Ganghyeok/EEG-Measurement_Brain-Stimulation_System/README.md

# EEG-Measurement_Brain-Stimulation_System
