Ganghyeok/EEG-Measurement_Brain-Stimulation_System/Hardware/EEG_Ver1.0A/PDF/2_EEG_Ver1.0A(회로도 1차 검토 완료본).pdf

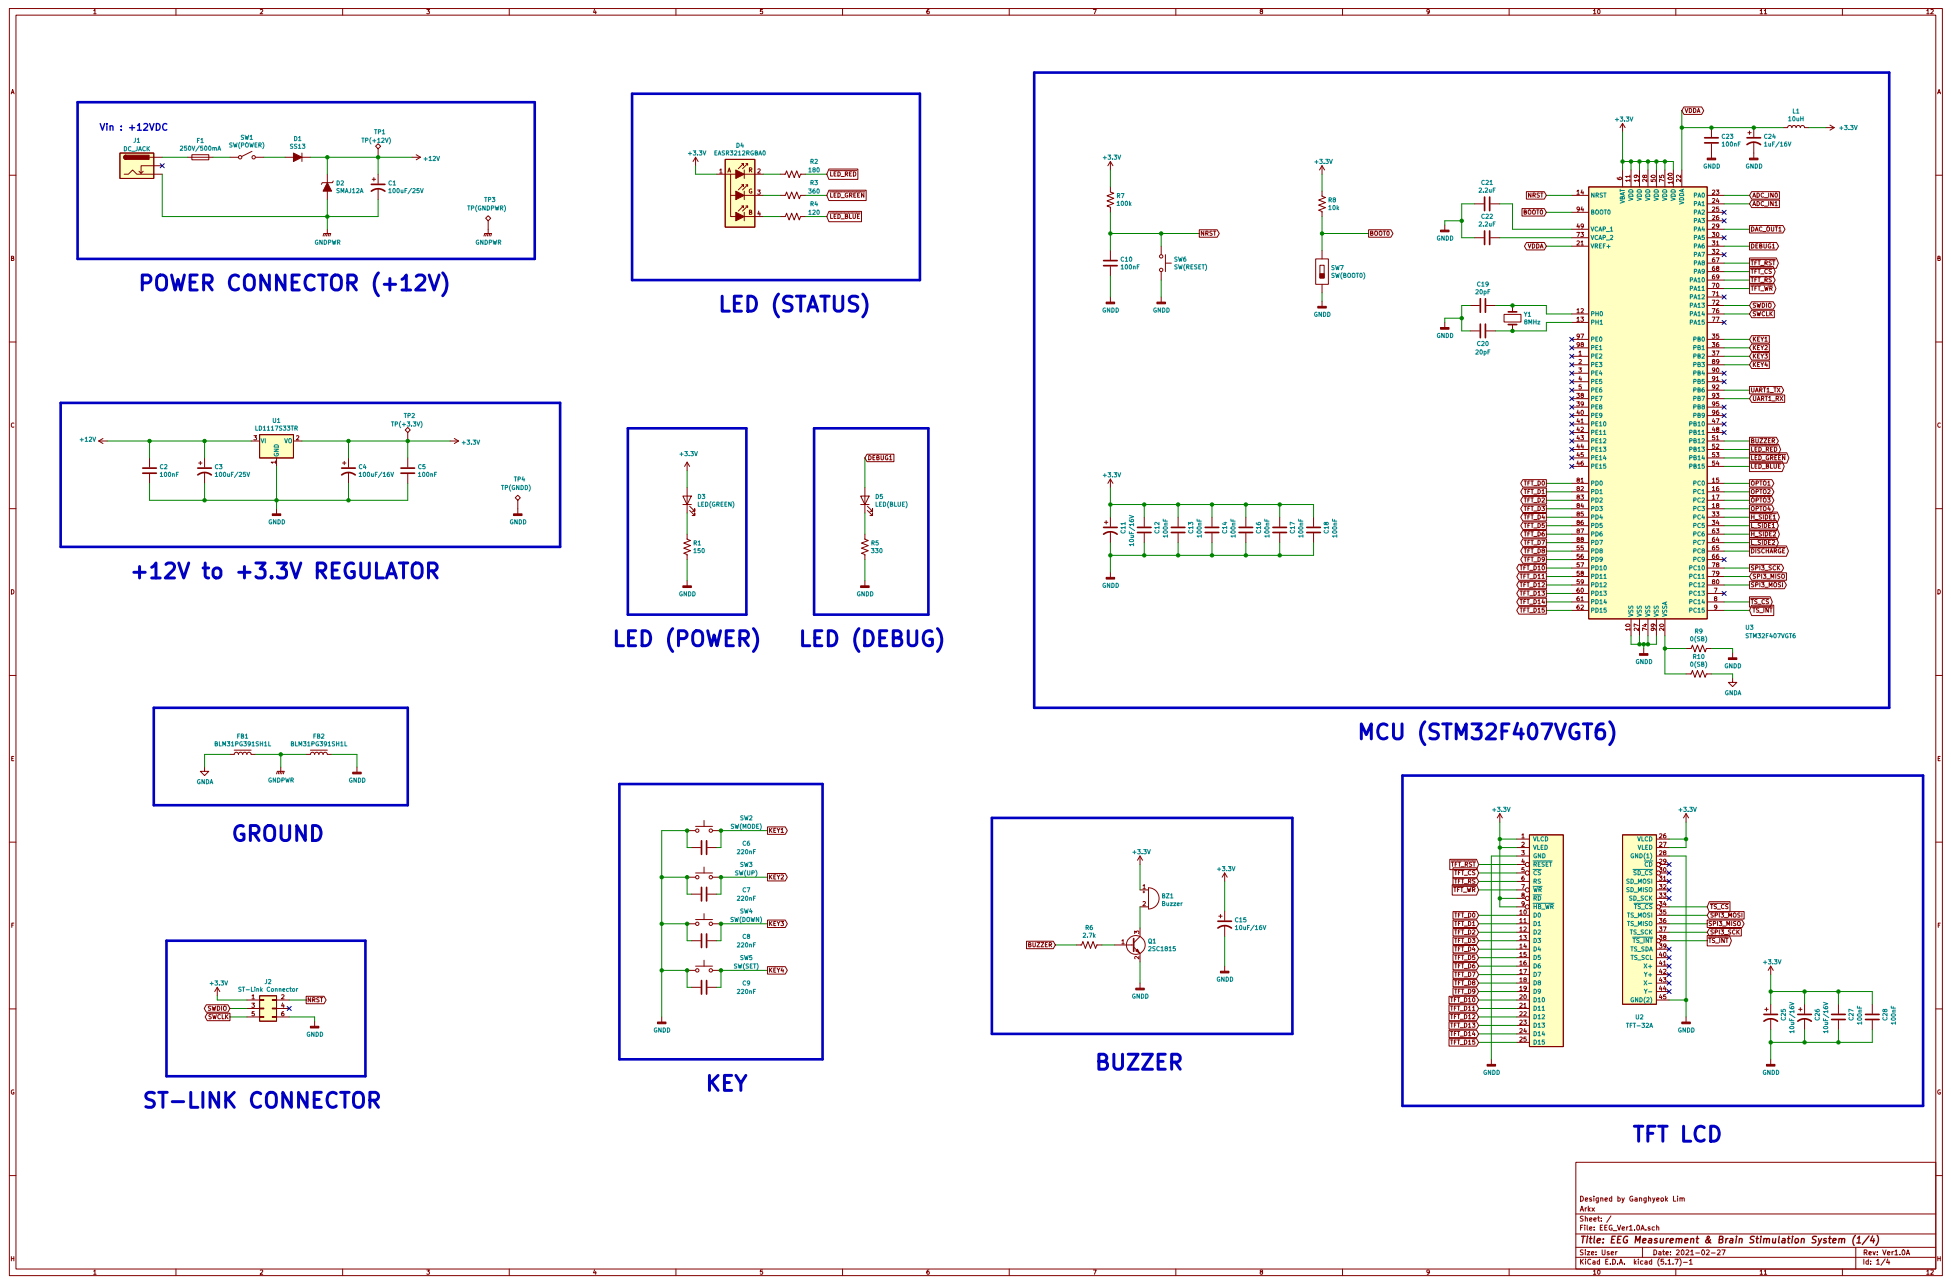
[picture p5: page 1]

Sheet: EEG Measurement & Stimulation System (2/4) File: file603BAA17.sch GNDD

SW2 SW(MODE) SW3 SW(UP)

File: EEG_Ver1.0A.sch Sheet: / Arkx Designed by Ganghyeok Lim

Id: 1/4 Title: EEG Measurement & Brain Stimulation System (1/4)

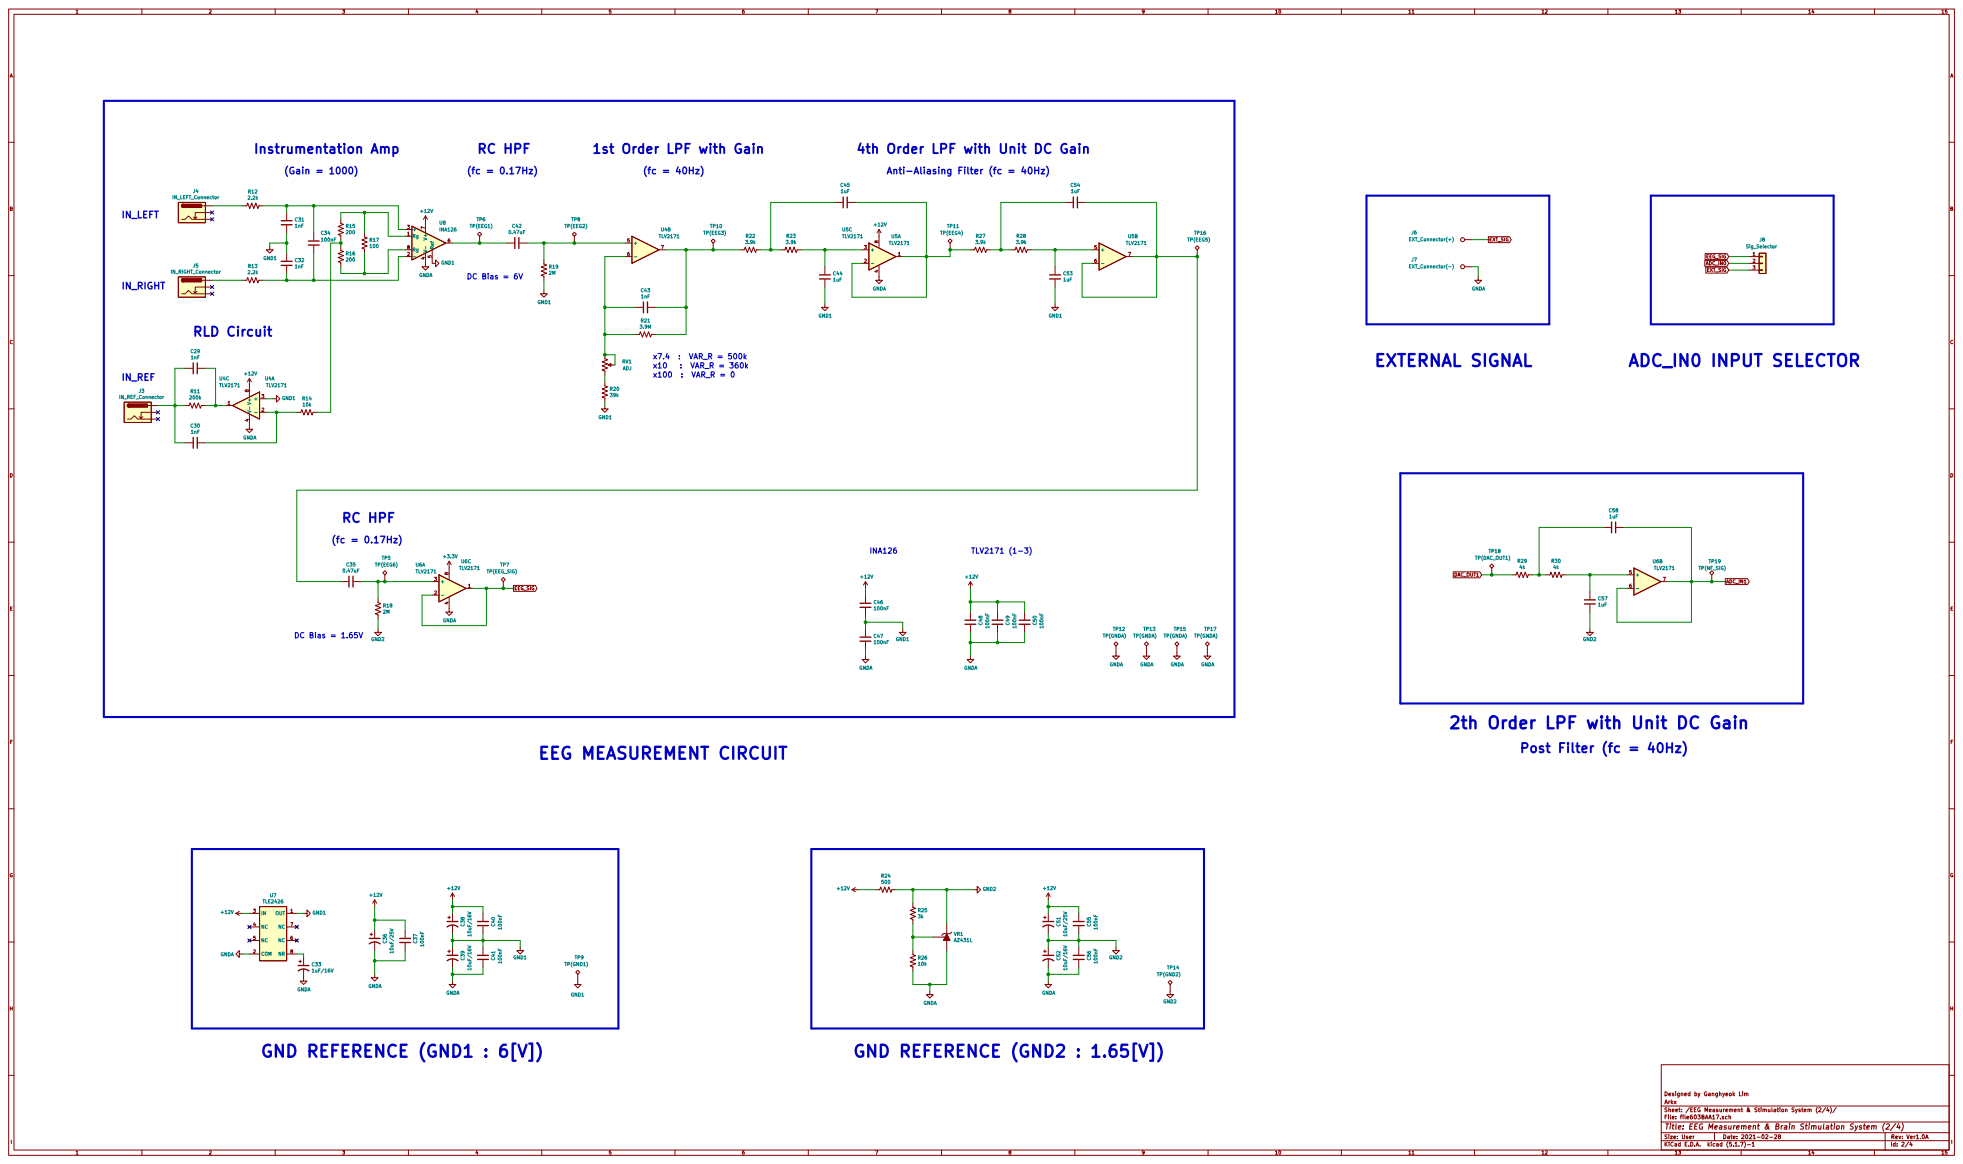
[picture p6: page 2]

1st Order LPF with Gain

4th Order LPF with Unit DC Gain

Anti-Aliasing Filter (fc = 40Hz)

TP16 TP(EEG5) TP11 TP(EEG4) TP10 TP(EEG3) TP8 TP(EEG2) TP6 TP(EEG1)

TP19 TP(NF_SIG) TP18 TP(DAC_OUT1) TP7 TP(EEG_SIG) TP5 TP(EEG6)

Id: 2/4 Title: EEG Measurement & Brain Stimulation System (2/4) File: file603BAA17.sch Sheet: /EEG Measurement & Stimulation System (2/4)/ Arkx Designed by Ganghyeok Lim C49 100nF

2th Order LPF with Unit DC Gain

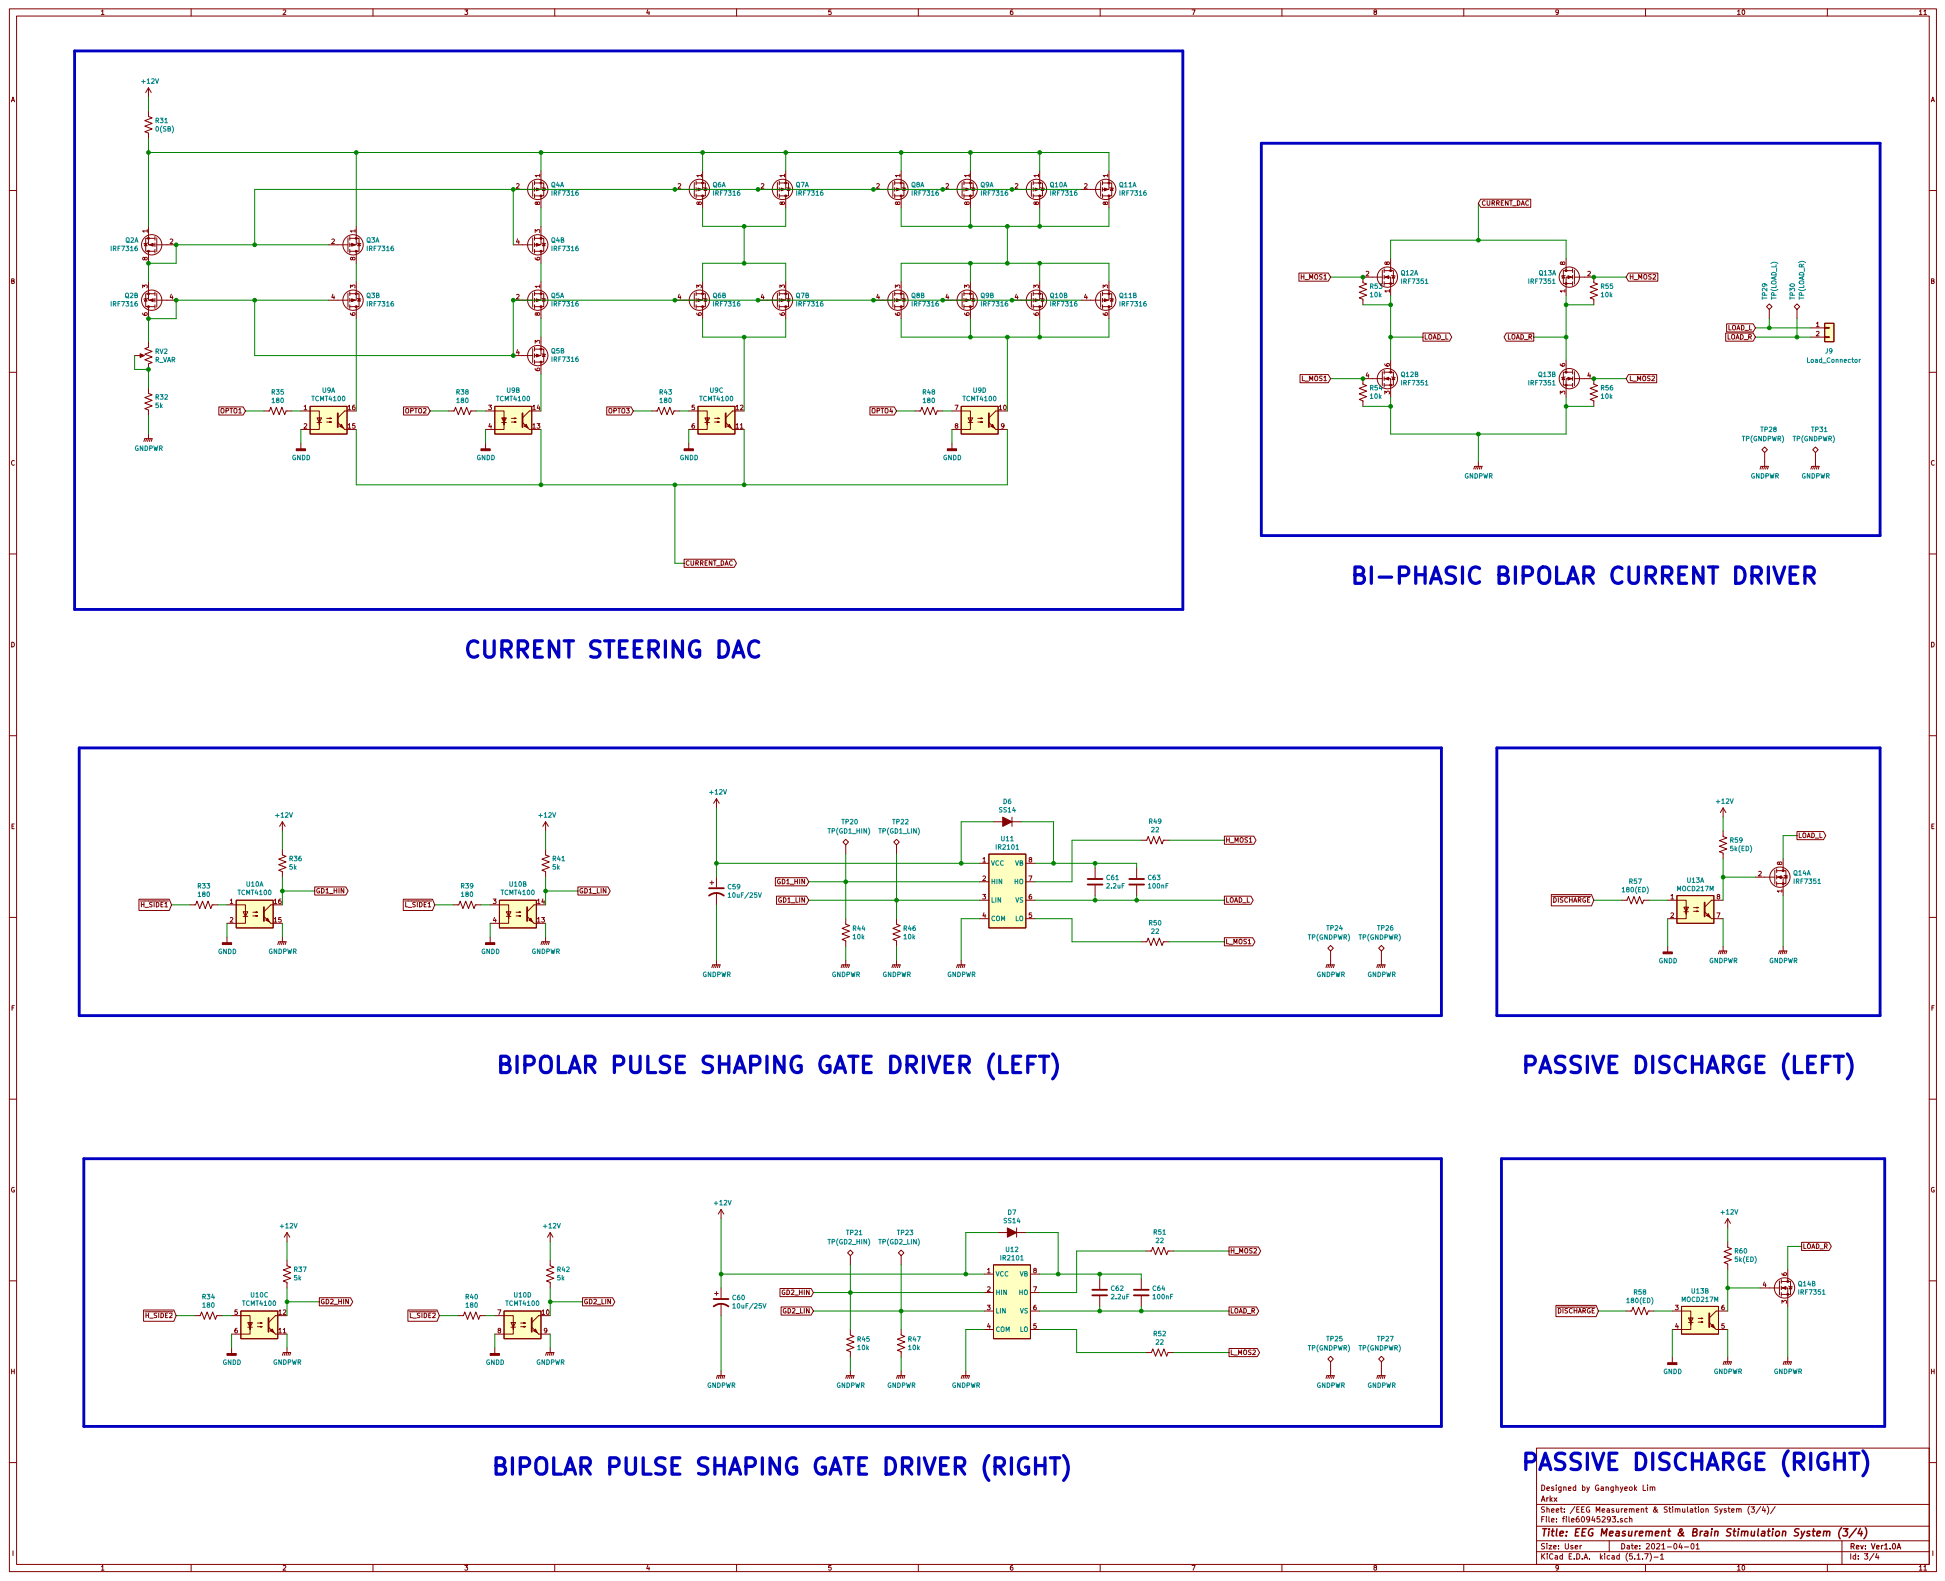
[picture p7: page 3]

BI-PHASIC BIPOLAR CURRENT DRIVER

BIPOLAR PULSE SHAPING GATE DRIVER (LEFT)

Id: 3/4 Title: EEG Measurement & Brain Stimulation System (3/4) File: file60945293.sch Sheet: /EEG Measurement & Stimulation System (3/4)/ Arkx Designed by Ganghyeok Lim

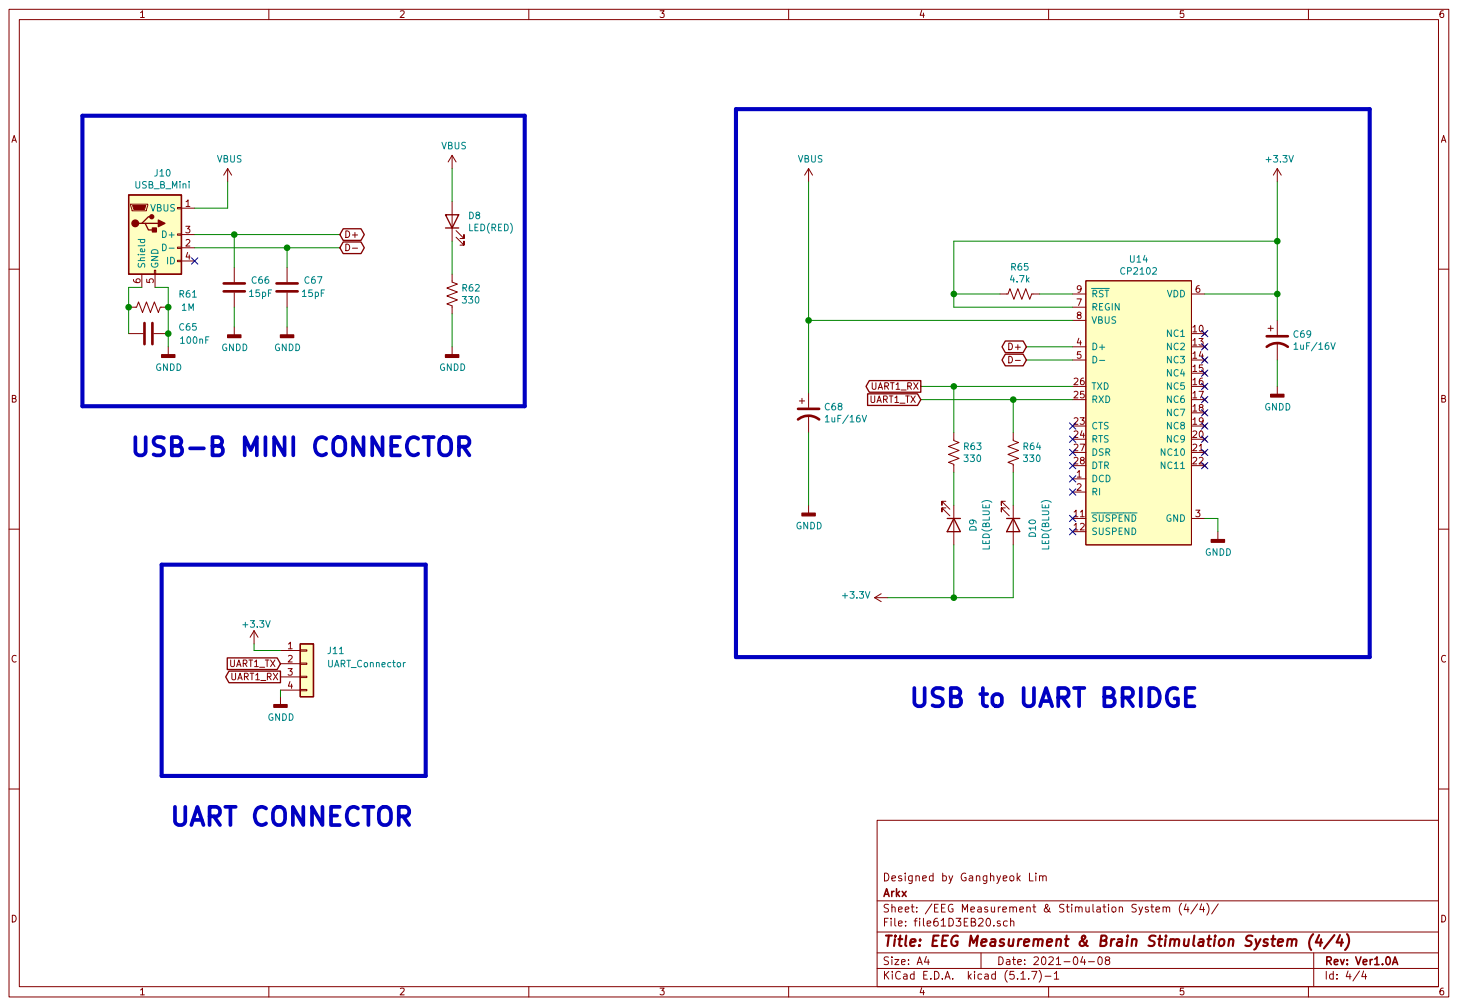
[picture p8: page 4]

USB to UART BRIDGE

Id: 4/4 Title: EEG Measurement & Brain Stimulation System (4/4) File: file61D3EB20.sch Sheet: /EEG Measurement & Stimulation System (4/4)/ Arkx Designed by Ganghyeok Lim
