Ganghyeok/EEG-Measurement_Brain-Stimulation_System/Hardware/EEG_Ver1.0A/PDF/2_EEG_Ver1.0A(회로도 수정 후 2차 검토 완료본).pdf

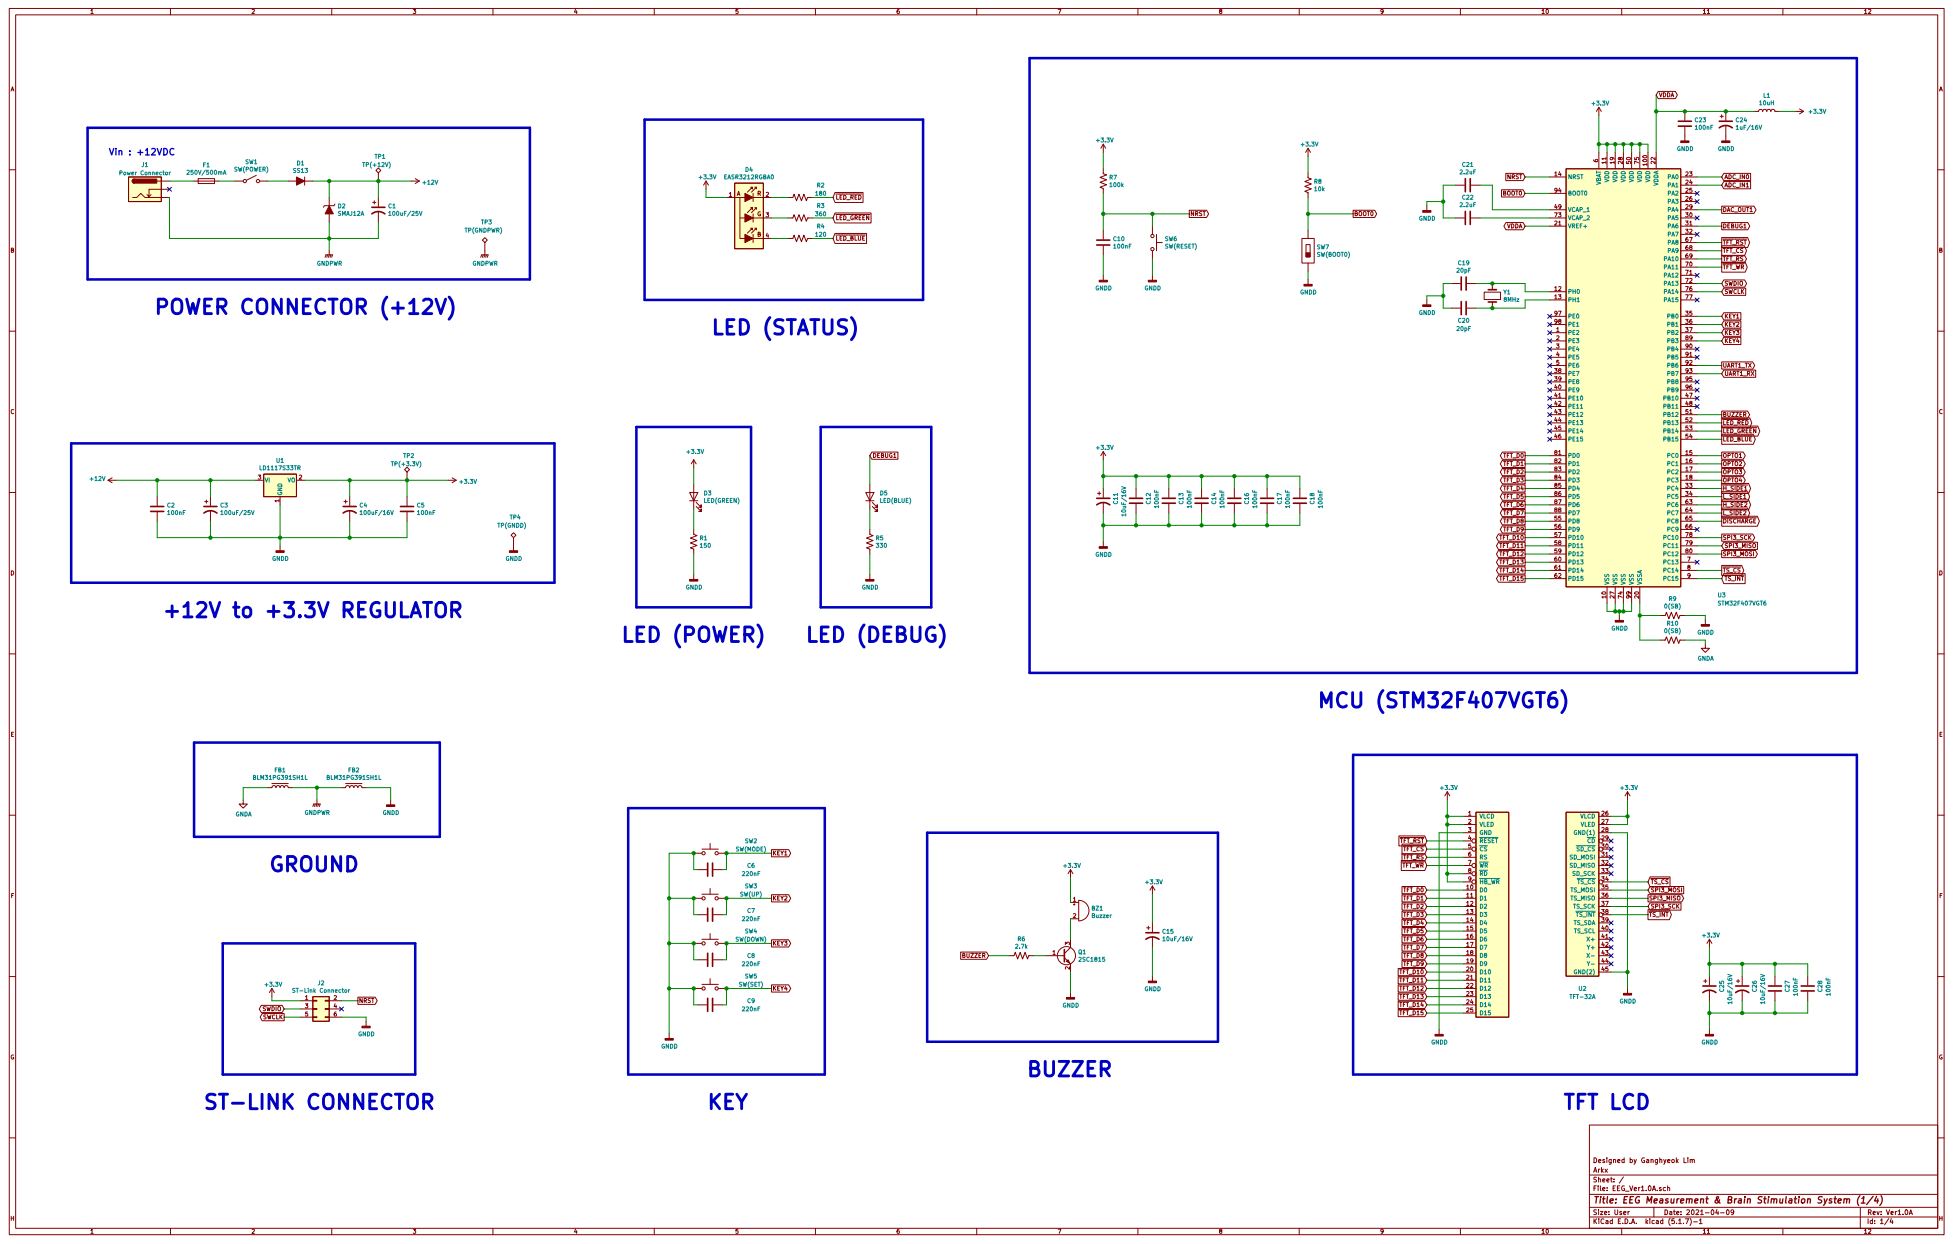
[picture p9: page 1]

Sheet: EEG Measurement & Stimulation System (2/4) File: file603BAA17.sch D3

File: EEG_Ver1.0A.sch Sheet: / Arkx Designed by Ganghyeok Lim

Id: 1/4 Title: EEG Measurement & Brain Stimulation System (1/4)

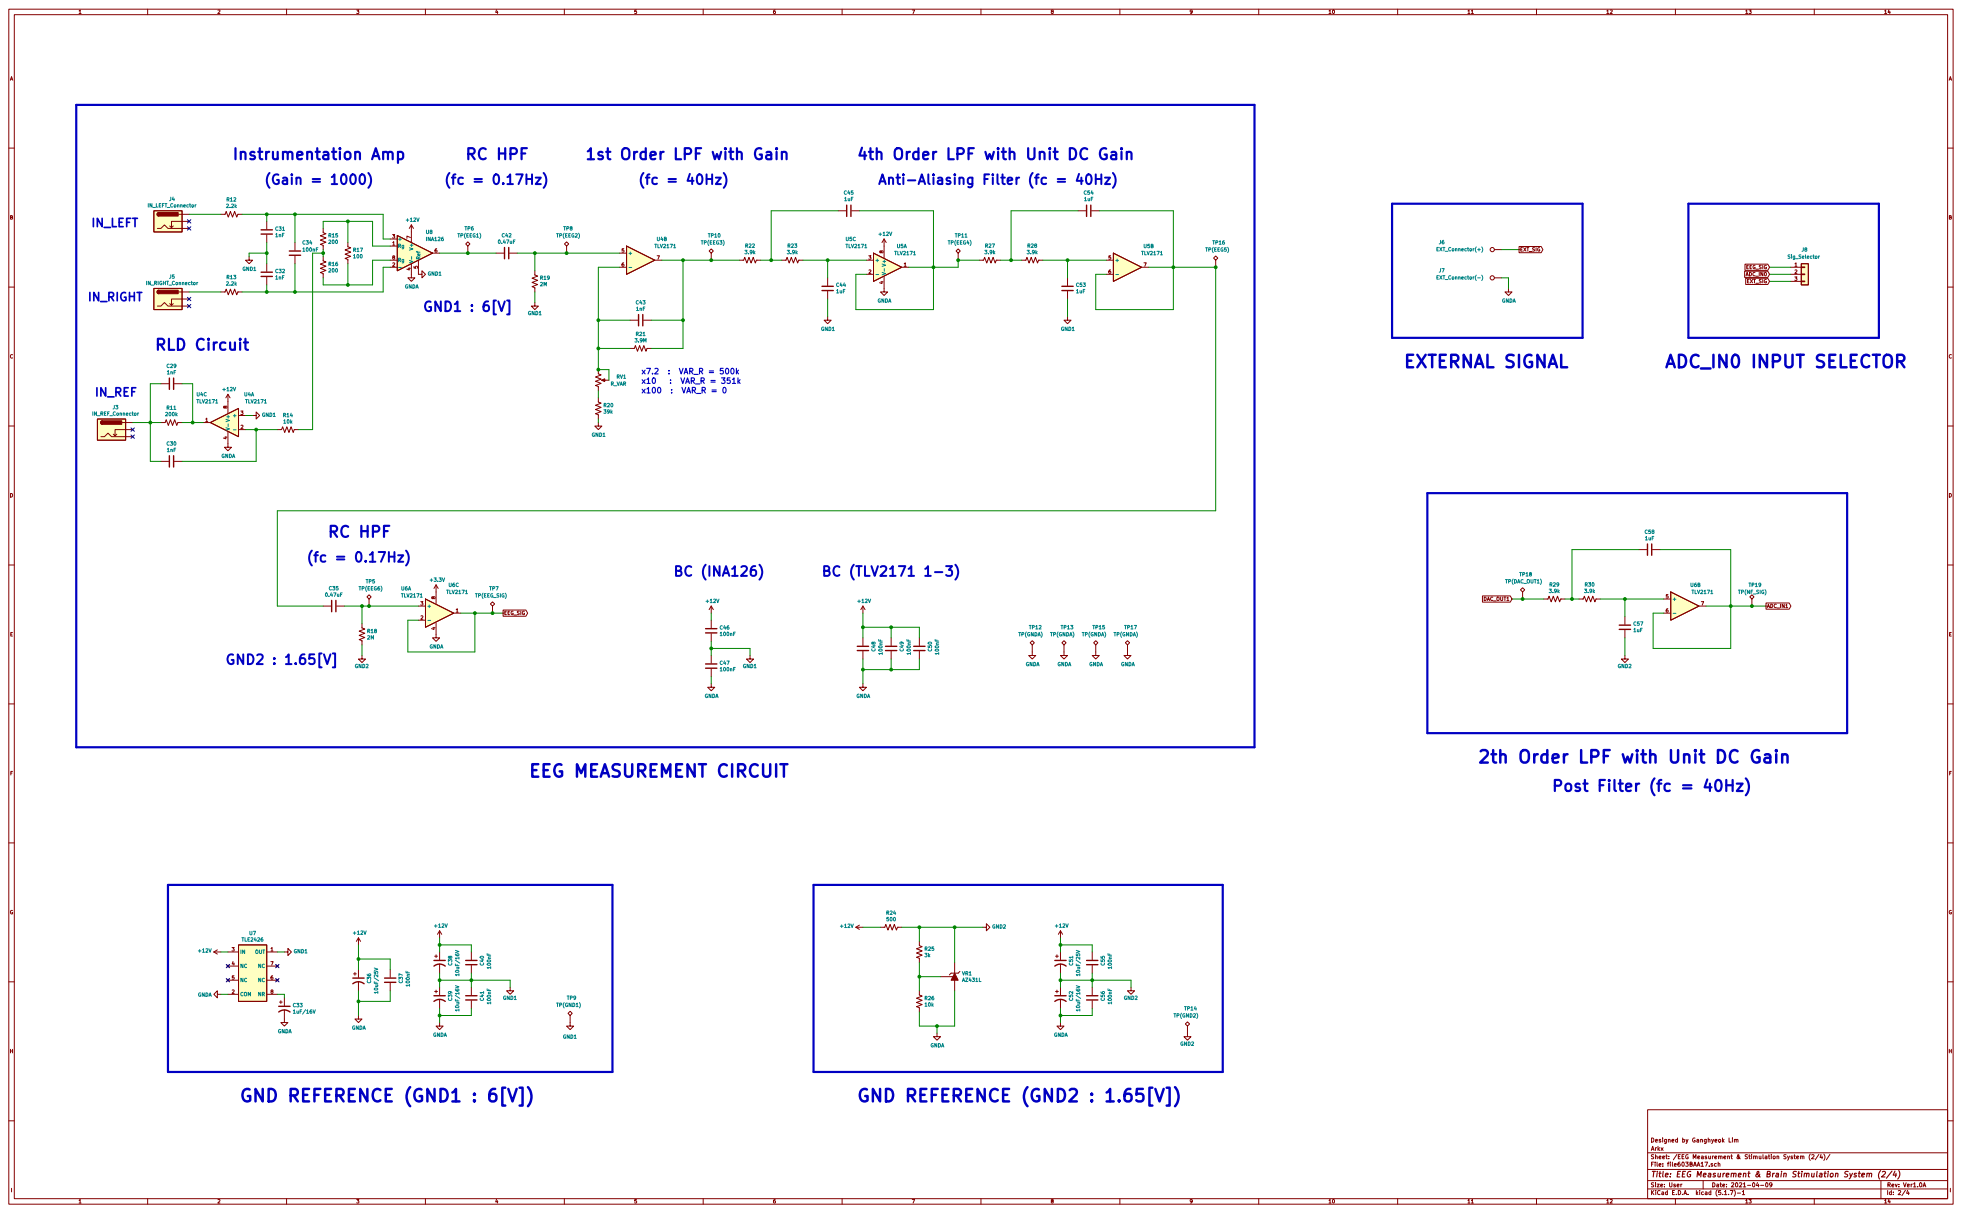
[picture p10: page 2]

4th Order LPF with Unit DC Gain

2th Order LPF with Unit DC Gain

Id: 2/4 Title: EEG Measurement & Brain Stimulation System (2/4) File: file603BAA17.sch Sheet: /EEG Measurement & Stimulation System (2/4)/ Arkx Designed by Ganghyeok Lim

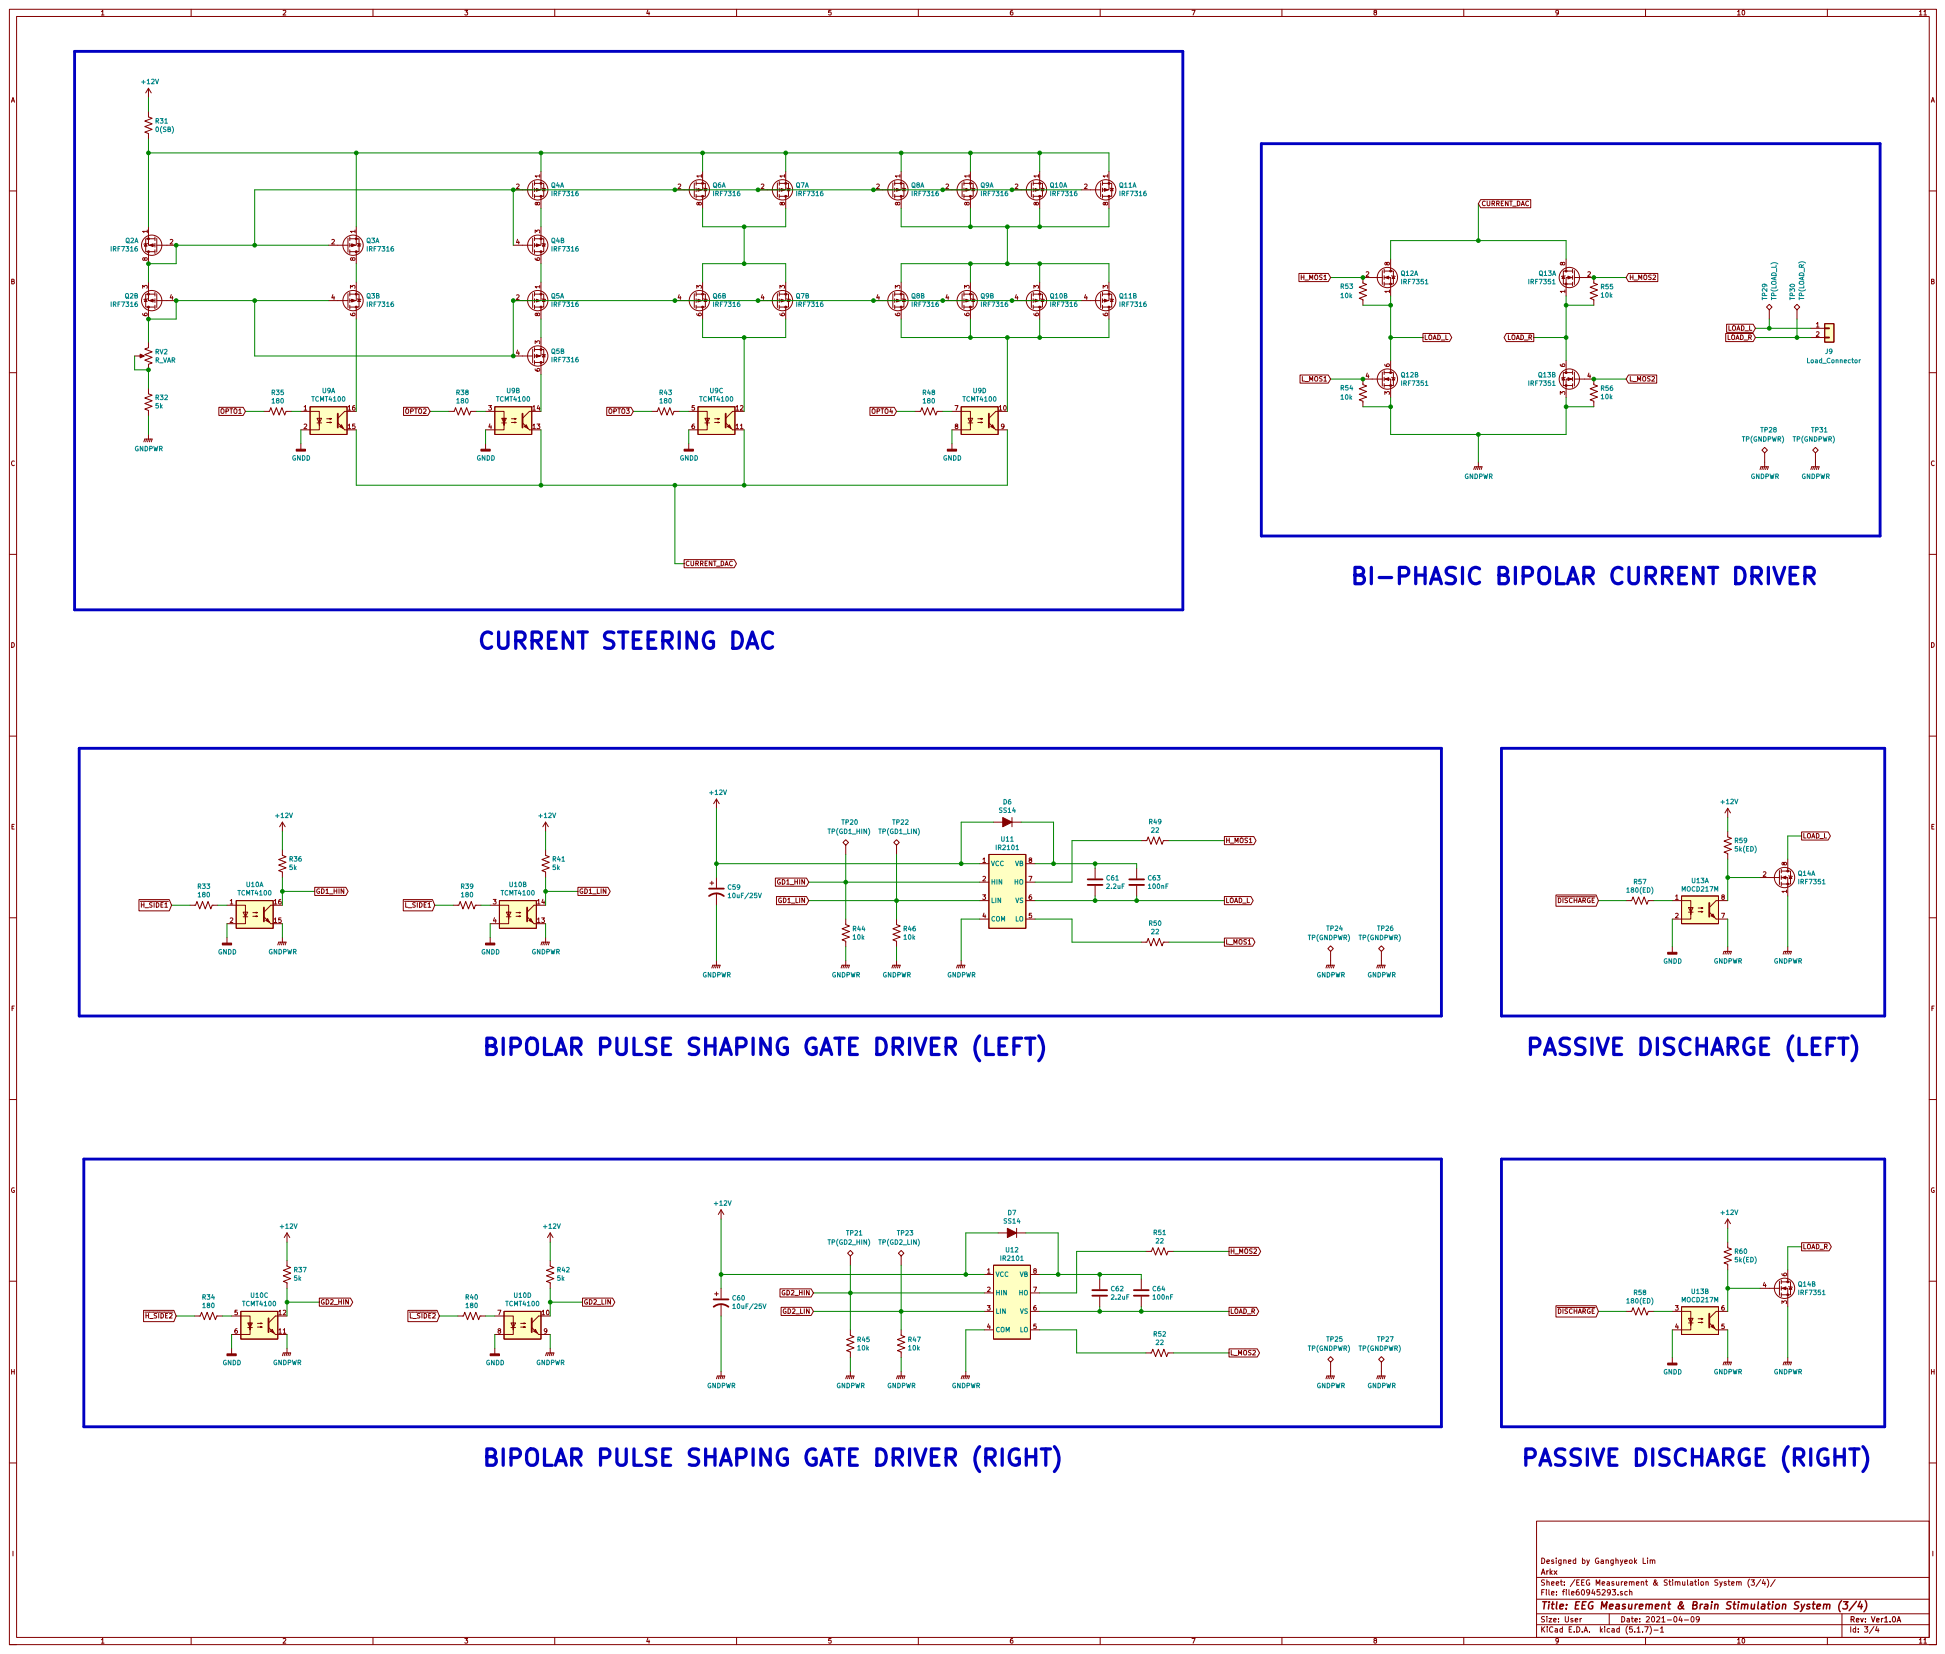
[picture p11: page 3]

BI-PHASIC BIPOLAR CURRENT DRIVER

BIPOLAR PULSE SHAPING GATE DRIVER (LEFT)

Id: 3/4 Title: EEG Measurement & Brain Stimulation System (3/4) File: file60945293.sch Sheet: /EEG Measurement & Stimulation System (3/4)/ Arkx Designed by Ganghyeok Lim

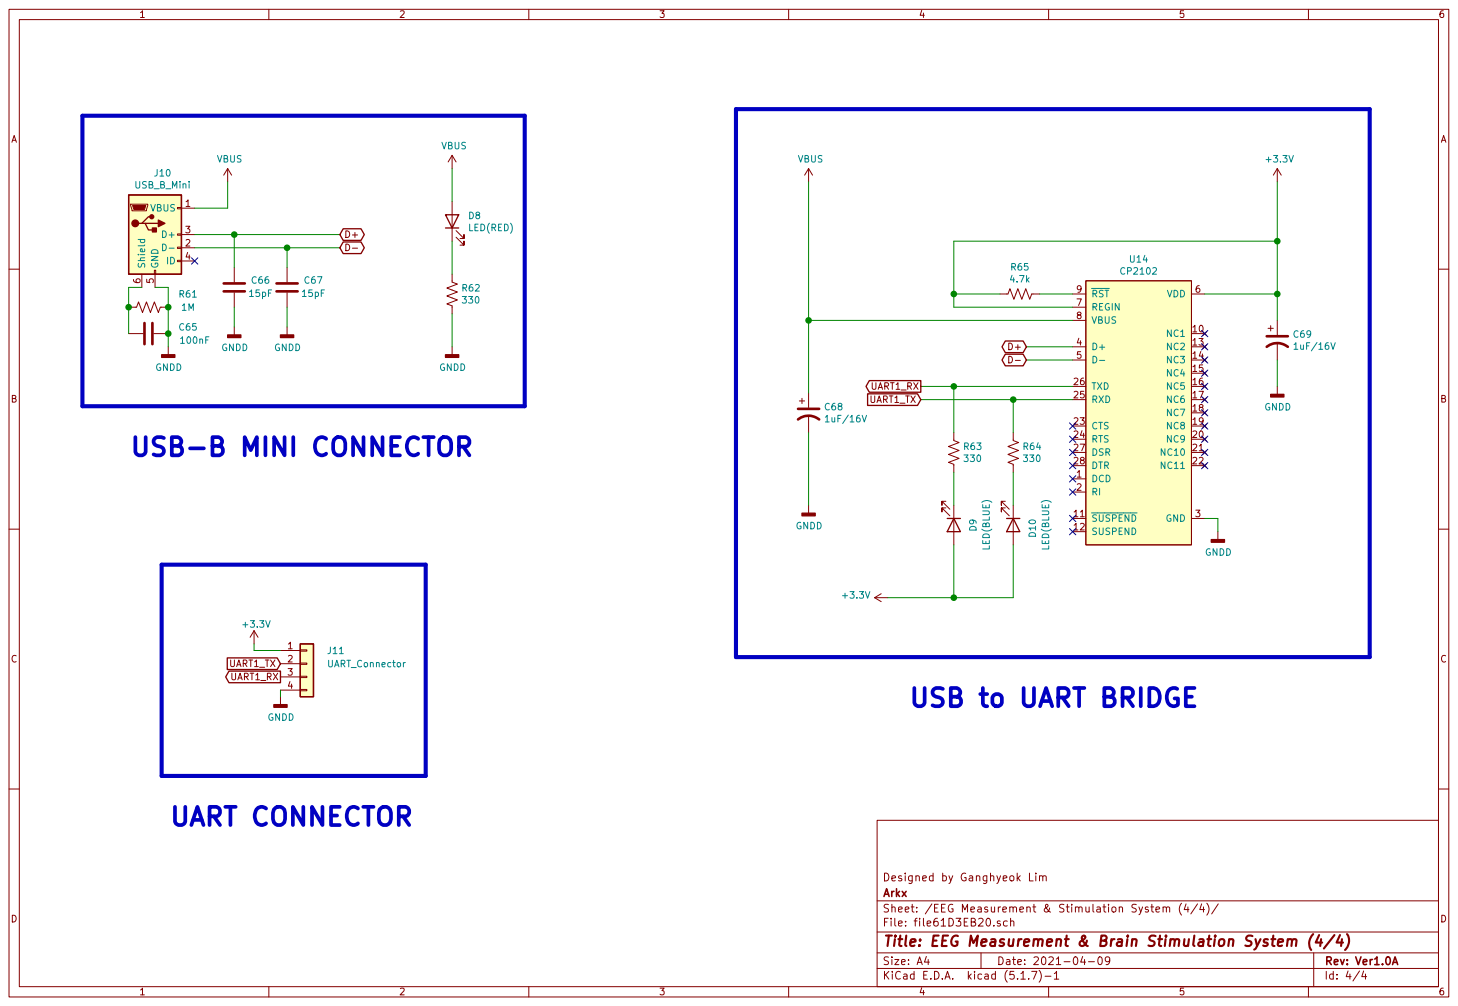
[picture p12: page 4]

USB to UART BRIDGE

Id: 4/4 Title: EEG Measurement & Brain Stimulation System (4/4) File: file61D3EB20.sch Sheet: /EEG Measurement & Stimulation System (4/4)/ Arkx Designed by Ganghyeok Lim
