Ganghyeok/EEG-Measurement_Brain-Stimulation_System/Hardware/EEG_Ver1.0A/PDF/1_EEG_Ver1.0A(회로도 작성 중간 백업본).pdf

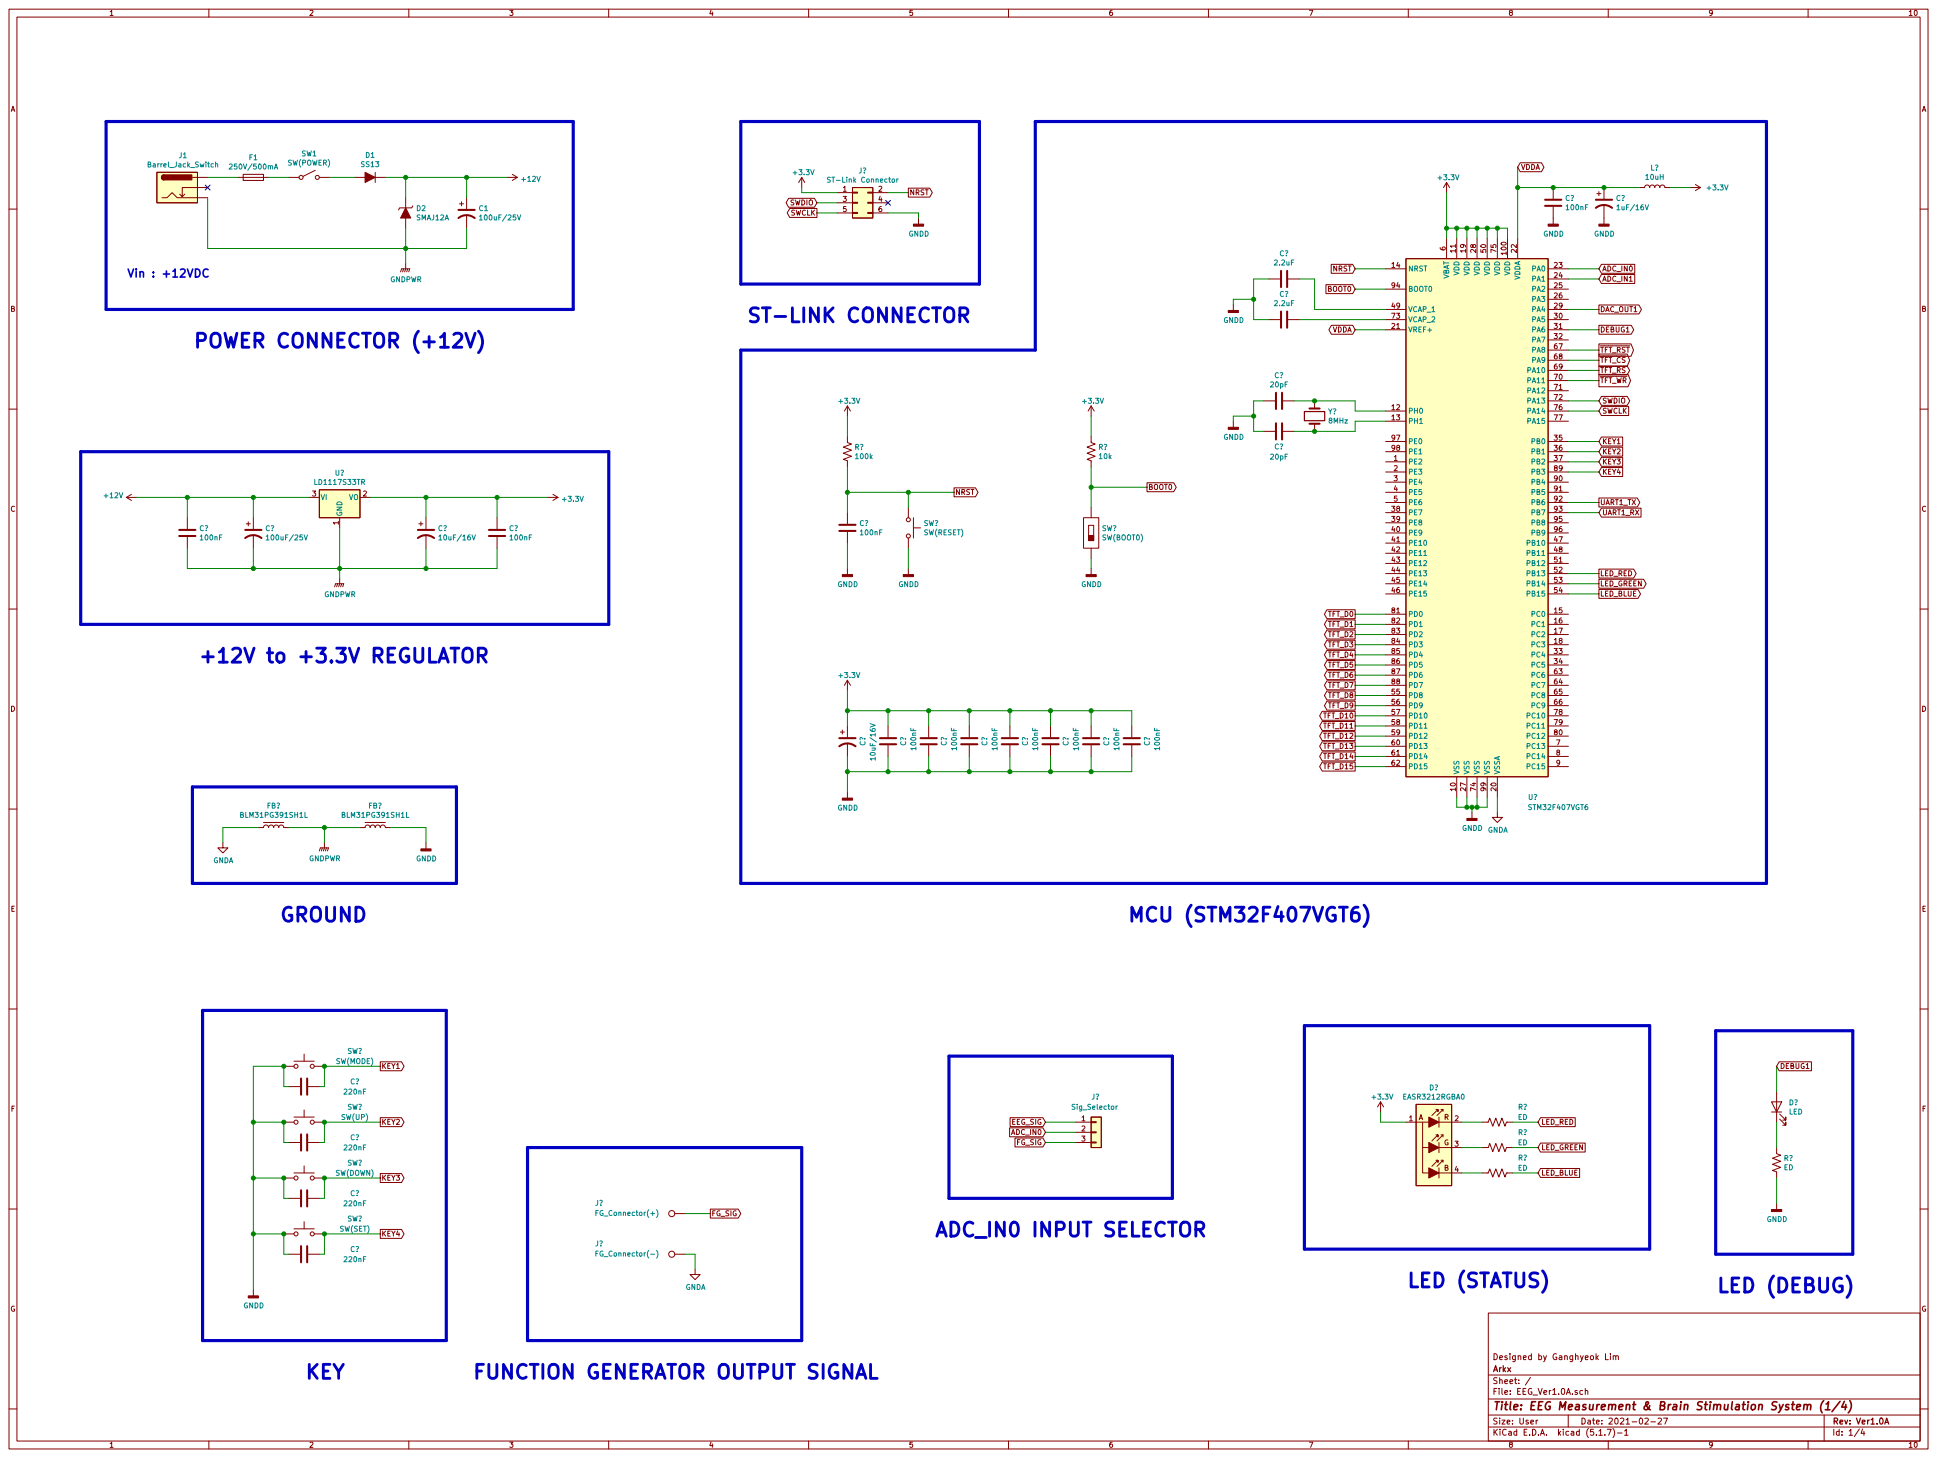
[picture p13: page 1]

SW? SW(UP) SW? SW(MODE)
KEY4 KEY3 KEY2 KEY1

FUNCTION GENERATOR OUTPUT SIGNAL

File: EEG_Ver1.0A.sch Sheet: / Arkx Designed by Ganghyeok Lim

Id: 1/4 Title: EEG Measurement & Brain Stimulation System (1/4)

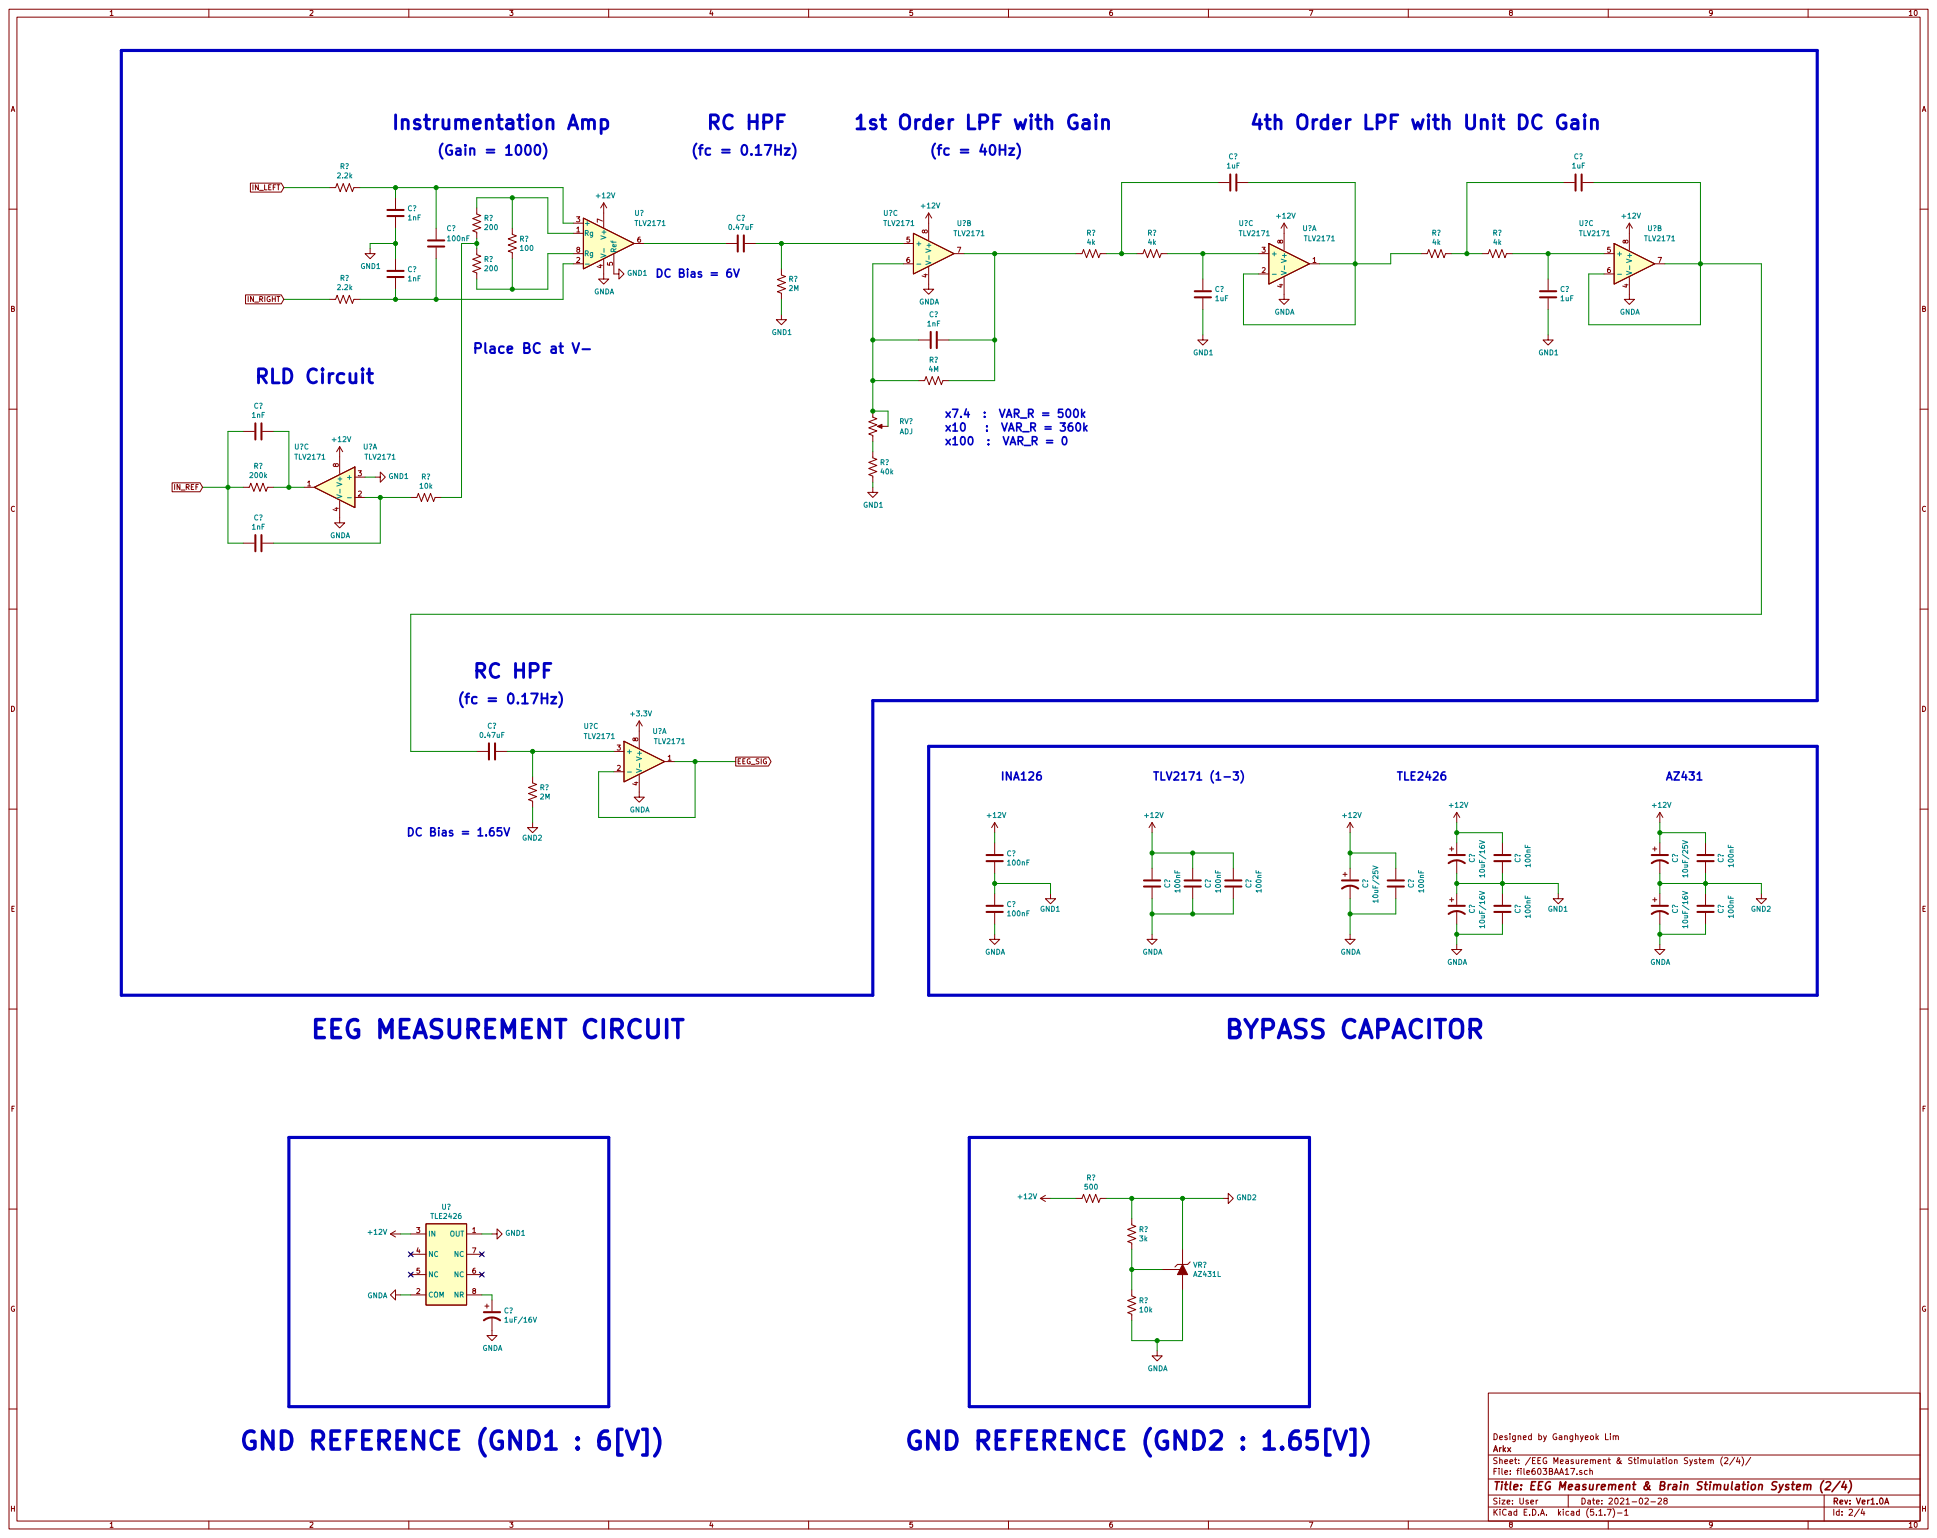
[picture p14: page 2]

1st Order LPF with Gain

4th Order LPF with Unit DC Gain

Id: 2/4 Title: EEG Measurement & Brain Stimulation System (2/4) File: file603BAA17.sch Sheet: /EEG Measurement & Stimulation System (2/4)/ Arkx Designed by Ganghyeok Lim

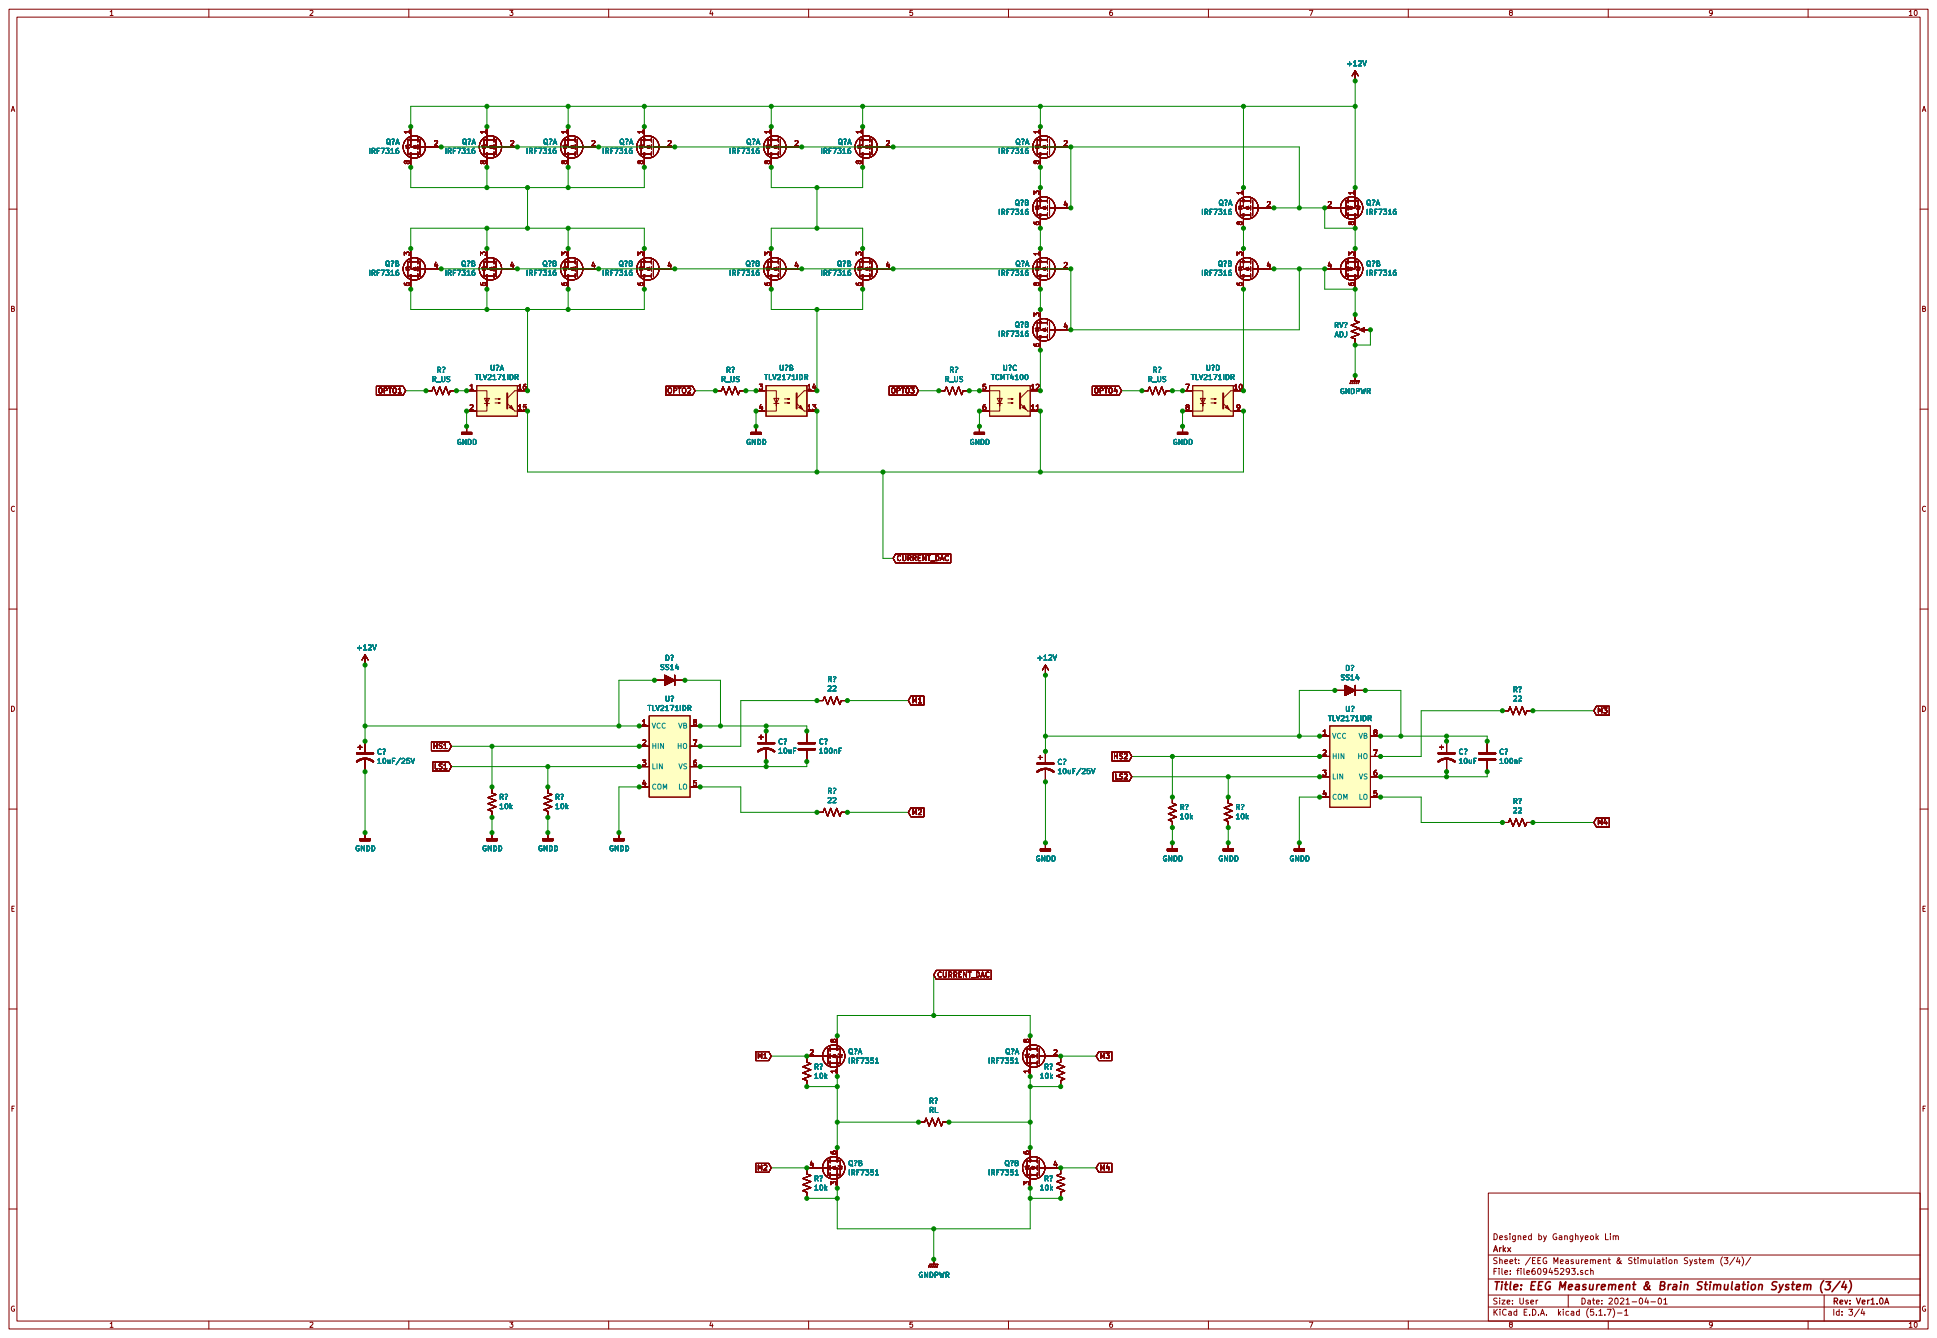
[picture p15: page 3]

Id: 3/4 Title: EEG Measurement & Brain Stimulation System (3/4) File: file60945293.sch Sheet: /EEG Measurement & Stimulation System (3/4)/ Arkx Designed by Ganghyeok Lim

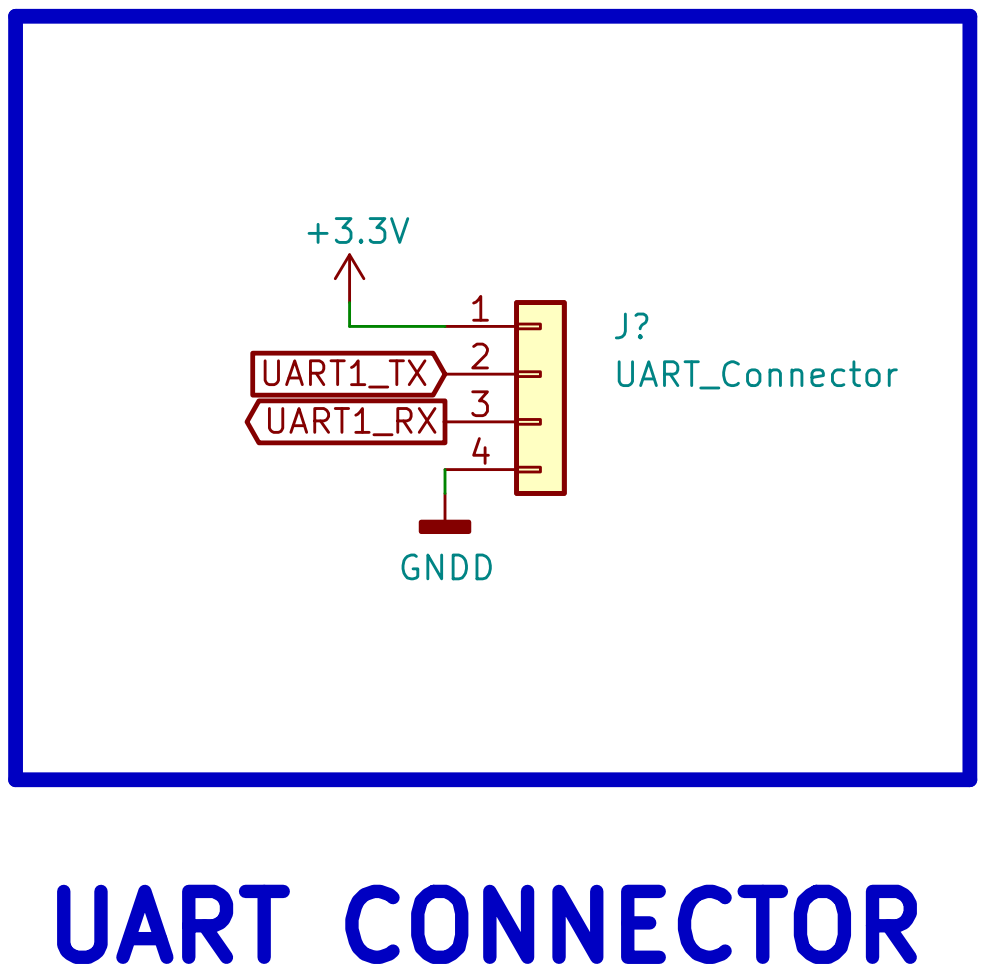
[picture p16: page 4]

Id: 4/4 Title: File: file61D3EB20.sch Sheet: /EEG Measurement & Stimulation System (4/4)/
