Ganghyeok/EEG-Measurement_Brain-Stimulation_System/Hardware/EEG_Ver1.0A/EEG_Ver1.0A.kicad_pcb

## KiCad design Hardware/EEG_Ver1.0A/EEG_Ver1.0A.kicad_pcb (2021-06-06)

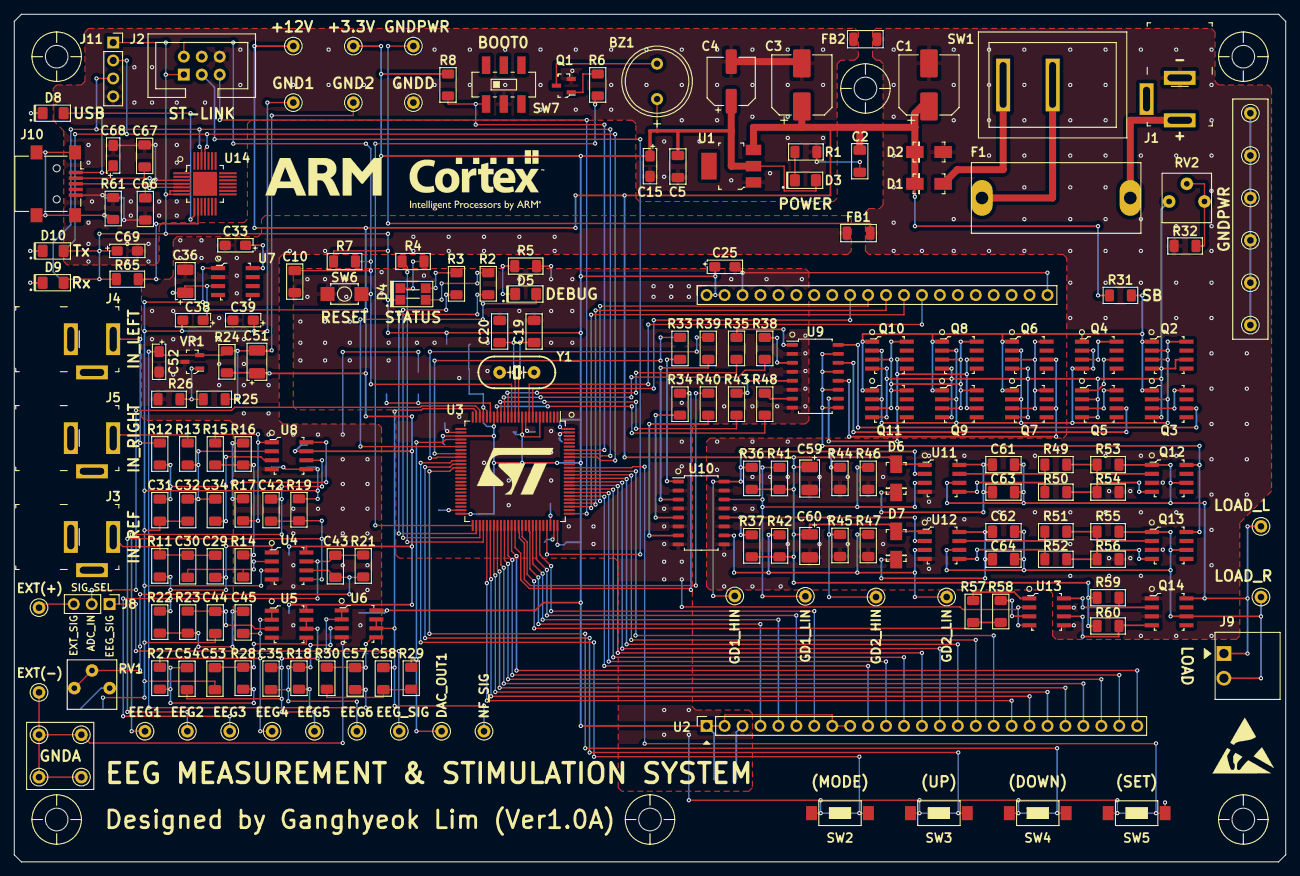
[picture p17: board EEG_Ver1.0A.kicad_pcb from above]

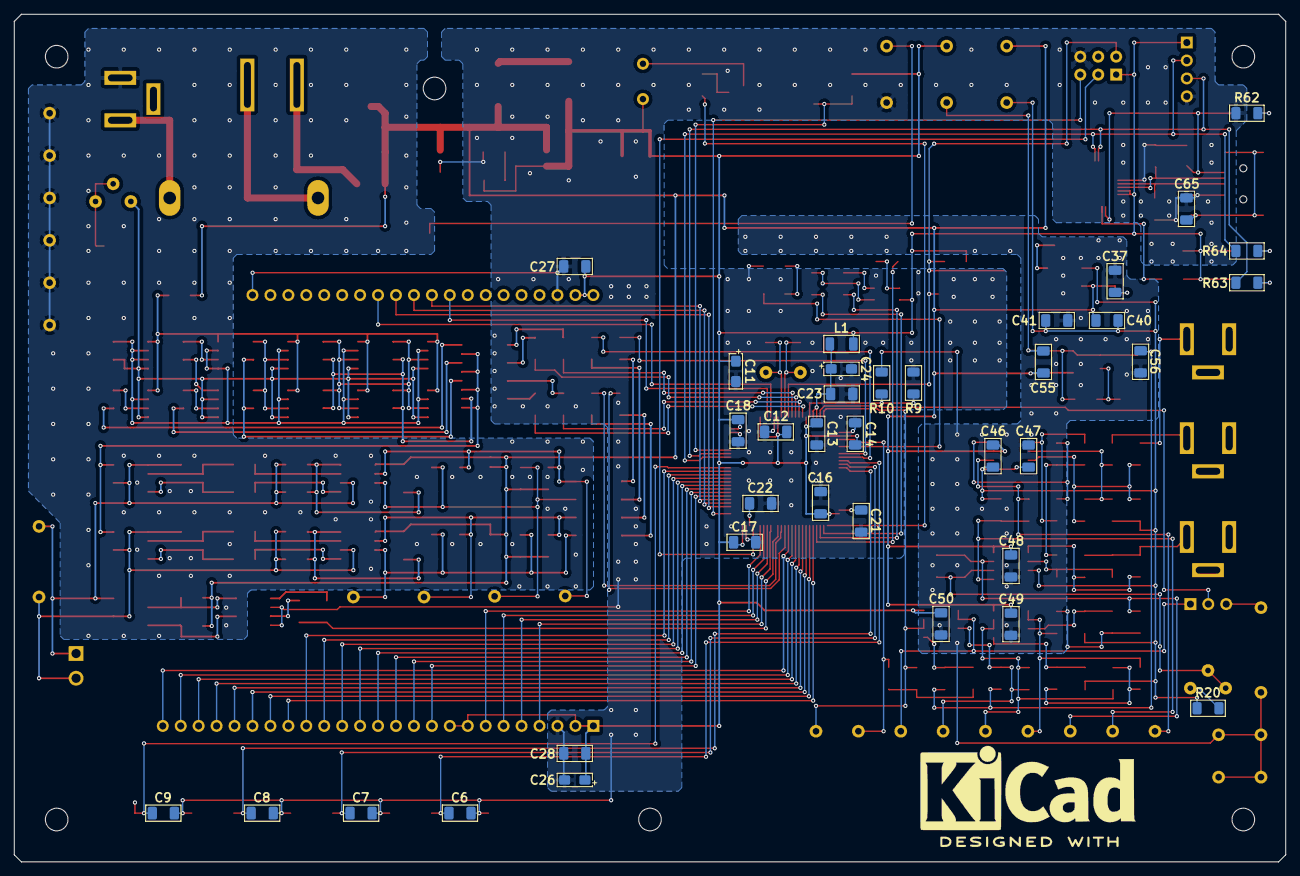
[picture p18: board EEG_Ver1.0A.kicad_pcb from below]

Board: 2 copper layers, 180.0 x 120.0 mm, 230 parts (36 on the bottom side), 154 nets.

Parts:
BZ1: Buzzer; FQ-013
C1, C3: 100uF/25V; CP_Elec_8x6.2
C2, C5, C10, C12, C13, C14, C16, C17, C18, C23, C27, C28, C34, C37, C40, C41, C46, C47, C48, C49, C50, C55, C56, C63, C64, C65: 100nF; C3216_Metric
C4: 100uF/16V; CP_Elec_6.3x5.3
C6, C7, C8, C9: 220nF; C3216_Metric
C11, C15, C25, C26, C38, C39, C52: 10uF/16V; C3216_Tantal_Metric
C19, C20: 20pF; C3216_Metric
C21, C22, C61, C62: 2.2uF; C3216_Metric
C24, C33, C68, C69: 1uF/16V; C3216_Tantal_Metric
C29, C30, C31, C32, C43: 1nF; C3216_Metric
C35, C42: 0.47uF; C3216_Metric
C36, C51, C59, C60: 10uF/25V; C3528_Tantal_Metric
C44, C45, C53, C54, C57, C58: 1uF; C3216_Metric
C66, C67: 15pF; C3216_Metric
D1: SS13; DO-214AC
D2: SMAJ12A; DO-214AC
D3: LED(GREEN); LED_3216_Metric
D4: EASR3212RGBA0
D5, D9, D10: LED(BLUE); LED_3216_Metric
D6, D7: SS14; DO-214AC
D8: LED(RED); LED_3216_Metric
F1: 250V/500mA; GF-205B(20mm)
FB1, FB2: BLM31PG391SH1L; L3216_Metric
J1: Power Connector; Barrel_Jack_5.5mmODx2.1mmID_PJ-202A
J2: ST-Link Connector; BHS-01-6P
J3: IN_REF_Connector; Barrel_Jack_5.5mmODx2.1mmID_PJ-202A
J4: IN_LEFT_Connector; Barrel_Jack_5.5mmODx2.1mmID_PJ-202A
J5: IN_RIGHT_Connector; Barrel_Jack_5.5mmODx2.1mmID_PJ-202A
J6: EXT_Connector(+); Test_Point(Loop)
J7: EXT_Connector(-); Test_Point(Loop)
J8: Sig_Selector; PinHeader_1x03_P2.54mm_Vertical
J9: Load_Connector; MOLEX_0395021002
J10: USB_B_Mini; USB_Mini-B_Lumberg_2486_01_Horizontal
J11: UART_Connector; PinSocket_1x04_P2.54mm_Vertical
L1: 10uH; L3216_Metric
Q1: 2SC1815; SOT-23-3
Q2, Q3, Q4, Q5, Q6, Q7, Q8, Q9, Q10, Q11: IRF7316; SOIC-8_W3.9mm
Q12, Q13, Q14: IRF7351; SOIC-8_W3.9mm
R1: 150; R3216_Metric
R2, R33, R34, R35, R38, R39, R40, R43, R48: 180; R3216_Metric
R3: 360; R3216_Metric
R4: 120; R3216_Metric
R5, R62, R63, R64: 330; R3216_Metric
R6: 2.7k; R3216_Metric
R7: 100k; R3216_Metric
R8, R14, R26, R44, R45, R46, R47, R53, R54, R55, R56: 10k; R3216_Metric
R9, R10, R31: 0(SB); R3216_Metric
R11: 200k; R3216_Metric
R12, R13: 2.2k; R3216_Metric
R15, R16: 200; R3216_Metric
R17: 100; R3216_Metric
R18, R19: 2M; R3216_Metric
R20: 39k; R3216_Metric
R21: 3.9M; R3216_Metric
R22, R23, R27, R28, R29, R30: 3.9k; R3216_Metric
R24: 500; R3216_Metric
R25: 3k; R3216_Metric
R32, R36, R37, R41, R42: 5k; R3216_Metric
R49, R50, R51, R52: 22; R3216_Metric
R57, R58: 180(ED); R3216_Metric
R59, R60: 5k(ED); R3216_Metric
R61: 1M; R3216_Metric
R65: 4.7k; R3216_Metric
RV1, RV2: R_VAR; Tocos_GF063P
SW1: SW(POWER); KCD1-101A
SW2: SW(MODE); ITS-1107(SMD)
SW3: SW(UP); ITS-1107(SMD)
SW4: SW(DOWN); ITS-1107(SMD)
SW5: SW(SET); ITS-1107(SMD)
SW6: SW(RESET); SW_TACT_SMD_W3.9mm_L2.9mm_H2mm_GH
SW7: SW(BOOT0); SW_Slide_6P_SMD_GH
TP1: TP(+12V); Test_Point(Loop)
TP2: TP(+3.3V); Test_Point(Loop)
TP3, TP24, TP25, TP26, TP27, TP28, TP31: TP(GNDPWR); Test_Point(Loop)
TP4: TP(GNDD); Test_Point(Loop)
TP5: TP(EEG6); Test_Point(Loop)
TP6: TP(EEG1); Test_Point(Loop)
TP7: TP(EEG_SIG); Test_Point(Loop)
TP8: TP(EEG2); Test_Point(Loop)
TP9: TP(GND1); Test_Point(Loop)
TP10: TP(EEG3); Test_Point(Loop)
TP11: TP(EEG4); Test_Point(Loop)
TP12, TP13, TP15, TP17: TP(GNDA); Test_Point(Loop)
TP14: TP(GND2); Test_Point(Loop)
TP16: TP(EEG5); Test_Point(Loop)
TP18: TP(DAC_OUT1); Test_Point(Loop)
TP19: TP(NF_SIG); Test_Point(Loop)
TP20: TP(GD1_HIN); Test_Point(Loop)
TP21: TP(GD2_HIN); Test_Point(Loop)
TP22: TP(GD1_LIN); Test_Point(Loop)
TP23: TP(GD2_LIN); Test_Point(Loop)
TP29: TP(LOAD_L); Test_Point(Loop)
TP30: TP(LOAD_R); Test_Point(Loop)
U1: LD1117S33TR; SOT-223
U2: TFT-32A
U3: STM32F407VGT6; LQFP-100_14x14mm_P0.5mm
U4, U5, U6: TLV2171; SOIC-8_W3.9mm
U7: TLE2426; SOIC-8_W3.9mm
U8: INA126; SOIC-8_W3.9mm
U9, U10: TCMT4100; SOIC-16_4.55x10.3mm_P1.27mm
U11, U12: IR2101; SOIC-8_W3.9mm
U13: MOCD217M; SOIC-8_W3.9mm
U14: CP2102; VFQFN-28-1EP_5x5mm_HandSolder
VR1: AZ431L; SOT-23-3
Y1: 8MHz; CRYSTAL_HC49_PTH

Connections:
+3V3: BZ1.1, C4.1, C5.1, C11.1, C12.1, C13.1, C14.1, C15.1, C16.1, C17.1, C18.1, C25.1, C26.1, C27.1, C28.1, C50.1, C69.1, D3.2, D4.1, D9.2, D10.2, J2.1, J11.1, L1.2, R7.1, R8.1, R65.2, TP2.1, U1.2, U2.1, U2.2, U2.8, U2.9, U2.26, U2.27, U3.6, U3.11, U3.19, U3.28, U3.50, U3.75, U3.100, U6.8, U14.6, U14.7
+12V: C1.1, C2.1, C3.1, C36.1, C37.1, C38.1, C40.1, C46.1, C48.1, C49.1, C51.1, C55.1, C59.1, C60.1, D1.K, D2.K, D6.A, D7.A, R24.2, R31.1, R36.2, R37.2, R41.2, R42.2, R59.2, R60.2, TP1.1, U1.3, U4.8, U5.8, U7.3, U8.7, U11.1, U12.1
ADC_IN0: J8.2, U3.23
ADC_IN1: C58.1, TP19.1, U3.24, U6.6, U6.7
BOOT0: R8.2, SW7.1, U3.94
BUZZER: R6.2, U3.51
CURRENT_DAC: Q12.8, Q13.8, U9.9, U9.11, U9.13, U9.15
D+: C66.2, J10.3, U14.4
D-: C67.2, J10.2, U14.5
DAC_OUT1: R29.2, TP18.1, U3.29
DEBUG1: D5.2, U3.31
EEG_SIG: J8.1, TP7.1, U6.1, U6.2
EXT_SIG: J6.1, J8.3
GD1_HIN: R36.1, R44.1, TP20.1, U10.16, U11.2
GD1_LIN: R41.1, R46.1, TP22.1, U10.14, U11.3
GD2_HIN: R37.1, R45.1, TP21.1, U10.12, U12.2
GD2_LIN: R42.1, R47.1, TP23.1, U10.10, U12.3
GND1: C31.2, C32.1, C38.2, C39.1, C40.2, C41.1, C44.1, C46.2, C47.1, C53.1, R19.1, R20.2, TP9.1, U4.3, U7.1, U8.5
GND2: C51.2, C52.1, C55.2, C56.1, C57.1, R18.2, R24.1, R25.1, TP14.1, VR1.2
GNDA: C33.2, C36.2, C37.2, C39.2, C41.2, C47.2, C48.2, C49.2, C50.2, C52.2, C56.2, FB1.1, J7.1, R10.1, R26.2, TP12.1, TP13.1, TP15.1, TP17.1, U4.4, U5.4, U6.4, U7.2, U8.4, VR1.3
GNDD: C2.2, C3.2, C4.2, C5.2, C6.2, C7.2, C8.2, C9.2, C10.2, C11.2, C12.2, C13.2, C14.2, C15.2, C16.2, C17.2, C18.2, C19.2, C20.2, C21.2, C22.2, C23.2, C24.2, C25.2, C26.2, C27.2, C28.2, C65.1, C66.1, C67.1, C68.2, C69.2, FB2.2, J2.6, J10.5, J11.4, Q1.2, R1.2, R5.2, R9.1, R61.1, R62.2, SW2.1, SW3.1, SW4.1, SW5.1, SW6.2, SW7.2, TP4.1, U1.1, U2.3, U2.28, U2.45, U3.10, U3.27, U3.74, U3.99, U9.2, U9.4, U9.6, U9.8, U10.2, U10.4, U10.6, U10.8, U13.2, U13.4, U14.3
GNDPWR: C1.2, C59.2, C60.2, D2.A, FB1.2, FB2.1, J1.2, Q12.3, Q13.3, Q14.1, Q14.3, R32.1, R44.2, R45.2, R46.2, R47.2, R54.1, R56.1, TP3.1, TP24.1, TP25.1, TP26.1, TP27.1, TP28.1, TP31.1, U10.9, U10.11, U10.13, U10.15, U11.4, U12.4, U13.5, U13.7
H_MOS1: Q12.2, R49.1, R53.2
H_MOS2: Q13.2, R51.1, R55.2
KEY1: C6.1, SW2.2, U3.35
KEY2: C7.1, SW3.2, U3.36
KEY3: C8.1, SW4.2, U3.37
KEY4: C9.1, SW5.2, U3.89
LOAD_L: C61.2, C63.2, J9.1, Q12.1, Q12.6, Q14.8, R53.1, TP29.1, U11.6
LOAD_R: C62.2, C64.2, J9.2, Q13.1, Q13.6, Q14.6, R55.1, TP30.1, U12.6
L_MOS1: Q12.4, R50.1, R54.2
L_MOS2: Q13.4, R52.1, R56.2
NRST: C10.1, J2.2, R7.2, SW6.1, U3.14
unnamed: BZ1.2, Q1.3
unnamed: C19.1, U3.12, Y1.1
unnamed: C20.1, U3.13, Y1.2
unnamed: C21.1, U3.49
unnamed: C22.1, U3.73
unnamed: C29.1, R11.2, U4.1
unnamed: C29.2, C30.2, J3.1, R11.1
unnamed: C30.1, R14.2, U4.2
unnamed: C31.1, C34.1, R12.2, U8.3
unnamed: C32.2, C34.2, R13.2, U8.2
unnamed: C33.1, U7.8
unnamed: C35.1, R18.1, TP5.1, U6.3
unnamed: C35.2, C54.2, TP16.1, U5.6, U5.7
unnamed: C42.1, R19.2, TP8.1, U4.5
unnamed: C42.2, TP6.1, U8.6
unnamed: C43.1, R21.1, R22.2, TP10.1, U4.7
unnamed: C43.2, R21.2, RV1.1, RV1.2, U4.6
unnamed: C44.2, R23.1, U5.3
unnamed: C45.1, R22.1, R23.2
unnamed: C45.2, R27.2, TP11.1, U5.1, U5.2
unnamed: C53.2, R28.1, U5.5
unnamed: C54.1, R27.1, R28.2
unnamed: C57.2, R30.1, U6.5
unnamed: C58.2, R29.1, R30.2
unnamed: C61.1, C63.1, D6.K, U11.8
unnamed: C62.1, C64.1, D7.K, U12.8
unnamed: C65.2, J10.6, R61.2
unnamed: D1.A, SW1.2
unnamed: D3.1, R1.1
unnamed: D4.2, R2.2
unnamed: D4.3, R3.2
unnamed: D4.4, R4.2
unnamed: D5.1, R5.1
unnamed: D8.1, R62.1
unnamed: D9.1, R63.2
unnamed: D10.1, R64.2
unnamed: F1.1, SW1.1
unnamed: F1.2, J1.1
unnamed: J4.1, R12.1
unnamed: J5.1, R13.1
unnamed: Q1.1, R6.1
unnamed: Q3.3, Q3.8
unnamed: Q3.6, U9.16
unnamed: Q4.3, Q4.8
unnamed: Q4.6, Q5.1
unnamed: Q5.3, Q5.8
unnamed: Q5.6, U9.14
unnamed: Q6.3, Q6.8, Q7.3, Q7.8
unnamed: Q6.6, Q7.6, U9.12
unnamed: Q2.1, Q3.1, Q4.1, Q6.1, Q7.1, Q8.1, Q9.1, Q10.1, Q11.1, R31.2
unnamed: Q2.2, Q2.3, Q2.8, Q3.2, Q4.2, Q4.4, Q6.2, Q7.2, Q8.2, Q9.2, Q10.2, Q11.2
unnamed: Q8.3, Q8.8, Q9.3, Q9.8, Q10.3, Q10.8, Q11.3, Q11.8
unnamed: Q2.4, Q2.6, Q3.4, Q5.2, Q5.4, Q6.4, Q7.4, Q8.4, Q9.4, Q10.4, Q11.4, RV2.1
unnamed: Q8.6, Q9.6, Q10.6, Q11.6, U9.10
unnamed: Q14.2, R59.1, U13.8
unnamed: Q14.4, R60.1, U13.6
unnamed: R9.2, R10.2, U3.20
unnamed: R14.1, R15.1, R16.1
unnamed: R15.2, R17.1, U8.1
unnamed: R16.2, R17.2, U8.8
unnamed: R20.1, RV1.3
unnamed: R25.2, R26.1, VR1.1
unnamed: R32.2, RV2.2, RV2.3
unnamed: R33.1, U10.1
unnamed: R34.1, U10.5
unnamed: R35.1, U9.1
unnamed: R38.1, U9.3
unnamed: R39.1, U10.3
unnamed: R40.1, U10.7
unnamed: R43.1, U9.5
unnamed: R48.1, U9.7
unnamed: R49.2, U11.7
unnamed: R50.2, U11.5
unnamed: R51.2, U12.7
unnamed: R52.2, U12.5
unnamed: R57.1, U13.1
unnamed: R58.1, U13.3
unnamed: R65.1, U14.9
OPTO1: R35.2, U3.15
OPTO2: R38.2, U3.16
OPTO3: R43.2, U3.17
OPTO4: R48.2, U3.18
SPI3_MISO: U2.36, U3.79
SPI3_MOSI: U2.35, U3.80
SPI3_SCK: U2.37, U3.78
SWCLK: J2.5, U3.76
SWDIO: J2.3, U3.72
TFT_D0: U2.10, U3.81
TFT_D1: U2.11, U3.82
TFT_D2: U2.12, U3.83
TFT_D3: U2.13, U3.84
TFT_D4: U2.14, U3.85
TFT_D5: U2.15, U3.86
TFT_D6: U2.16, U3.87
TFT_D7: U2.17, U3.88
TFT_D8: U2.18, U3.55
TFT_D9: U2.19, U3.56
TFT_D10: U2.20, U3.57
TFT_D11: U2.21, U3.58
TFT_D12: U2.22, U3.59
TFT_D13: U2.23, U3.60
TFT_D14: U2.24, U3.61
TFT_D15: U2.25, U3.62
TFT_RS: U2.6, U3.69
UART1_RX: J11.3, R63.1, U3.93, U14.26
UART1_TX: J11.2, R64.1, U3.92, U14.25
VBUS: C68.1, D8.2, J10.1, U14.8
VDDA: C23.1, C24.1, L1.1, U3.21, U3.22
~DISCHARGE: R57.2, R58.2, U3.65
~H_SIDE1: R33.2, U3.33
~H_SIDE2: R34.2, U3.63
~LED_BLUE: R4.1, U3.54
~LED_GREEN: R3.1, U3.53
~LED_RED: R2.1, U3.52
~L_SIDE1: R39.2, U3.34
~L_SIDE2: R40.2, U3.64
~TFT_CS: U2.5, U3.68
~TFT_RST: U2.4, U3.67
~TFT_WR: U2.7, U3.70
~TS_CS: U2.34, U3.8
~TS_INT: U2.38, U3.9
