Ganghyeok/EEG-Measurement_Brain-Stimulation_System/Firmware/DSP_Exercise/Src/tft.c

/*
 * tft.c
 *
 *  Created on: 2021. 3. 28.
 *      Author: Ganghyeok Lim
 */

#include "stm32f407xx.h"
#include "tft.h"

/**************************************************************************************************************/
/*									8 x 16 English ASCII Font (Myoung-Jo che)								  */
/**************************************************************************************************************/

const unsigned char E_font[128][16] = {		/* 8x16 English ASCII character font */
  {0x00,0x00,0x00,0x00,0x00,0x00,0x00,0x00,0x00,0x00,0x00,0x00,0x00,0x00,0x00,0x00}, // 0x00
  {0xF0,0x08,0x28,0x08,0x08,0x28,0x08,0xF0,0x07,0x08,0x09,0x0B,0x0B,0x09,0x08,0x07}, // 0x01
  {0xF0,0xF8,0xD8,0xF8,0xF8,0xD8,0xF8,0xF0,0x07,0x0F,0x0E,0x0C,0x0C,0x0E,0x0F,0x07}, // 0x02
  {0x00,0xF0,0xF8,0xF8,0xF0,0xF8,0xF8,0xF0,0x00,0x00,0x03,0x07,0x0F,0x07,0x03,0x00}, // 0x03
  {0x00,0x80,0xC0,0xE0,0xF0,0xE0,0xC0,0x80,0x00,0x00,0x01,0x03,0x07,0x03,0x01,0x00}, // 0x04
  {0x00,0xC0,0xC0,0xF8,0xF8,0xF8,0xC0,0xC0,0x00,0x03,0x0B,0x09,0x0F,0x09,0x0B,0x03}, // 0x05
  {0x00,0xC0,0xE0,0xF0,0xF8,0xF0,0xE0,0xC0,0x00,0x01,0x0B,0x0B,0x0F,0x0B,0x0B,0x01}, // 0x06
  {0x00,0x00,0x80,0xC0,0xC0,0x80,0x00,0x00,0x00,0x00,0x01,0x03,0x03,0x01,0x00,0x00}, // 0x07
  {0xFE,0xFE,0x7E,0x3E,0x3E,0x7E,0xFE,0xFE,0x7F,0x7F,0x7E,0x7C,0x7C,0x7E,0x7F,0x7F}, // 0x08
  {0x00,0xC0,0x60,0x20,0x20,0x60,0xC0,0x00,0x00,0x03,0x06,0x04,0x04,0x06,0x03,0x00}, // 0x09
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
  {0x00,0x00,0x00,0x00,0x00,0x00,0x00,0x00,0xC0,0x70,0x18,0x00,0x00,0x00,0x00,0x00,0xC0,0x70, // /
   0x1C,0x07,0x01,0x00,0x00,0x00,0x00,0x10,0x1C,0x07,0x01,0x00,0x00,0x00,0x00,0x00,0x00,0x00},
  {0x00,0x80,0xE0,0x70,0x10,0x18,0x08,0x18,0x10,0x70,0xE0,0x80,0x00,0xFF,0xFF,0x00,0x00,0x00, // 0
   0x00,0x00,0x00,0x00,0xFF,0xFF,0x00,0x00,0x03,0x07,0x04,0x0C,0x08,0x0C,0x04,0x07,0x03,0x00},
  {0x00,0x00,0x00,0x00,0x40,0x60,0xF0,0xF8,0x00,0x00,0x00,0x00,0x00,0x00,0x00,0x00,0x00,0x00, // 1
   0xFF,0xFF,0x00,0x00,0x00,0x00,0x00,0x00,0x00,0x00,0x08,0x08,0x0F,0x0F,0x08,0x08,0x00,0x00},
  {0x00,0xE0,0xF0,0x18,0x08,0x08,0x08,0x08,0x18,0xF0,0xE0,0x00,0x00,0x00,0x00,0x80,0xC0,0x60, // 2
   0x30,0x18,0x0C,0x07,0x03,0x00,0x00,0x0E,0x0F,0x09,0x08,0x08,0x08,0x08,0x08,0x0E,0x0E,0x00},
  {0x00,0x00,0xE0,0xF0,0x18,0x08,0x08,0x08,0x18,0xF0,0xE0,0x00,0x00,0x80,0x80,0x00,0x00,0x0C, // 3
   0x0C,0x0C,0x0E,0x1B,0xF1,0xE0,0x00,0x01,0x03,0x06,0x0C,0x08,0x08,0x08,0x0C,0x06,0x03,0x01},
  {0x00,0x00,0x00,0x00,0x00,0xC0,0x70,0xF8,0xF8,0x00,0x00,0x00,0x00,0xC0,0xF0,0x9C,0x87,0x81, // 4
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


/**************************************************************************************************************
 * 																											  *
 * 											APIs supported by this driver									  *
 * 						For more information about the APIs, Check the function definitions					  *
 * 									  																		  *
 **************************************************************************************************************/

void TFT_Init(TFT_HandleTypeDef *pTFTHandle)
{
	// Init the Low level hardware of TFT LCD : GPIO
	TFT_MspInit(pTFTHandle);

	GPIO_WritePin(pTFTHandle->Init.GPIOx_TFT_Control, pTFTHandle->Init.GPIO_Pin_TFT_nRST, GPIO_PIN_RESET);
	Delay_ms(1);
	GPIO_WritePin(pTFTHandle->Init.GPIOx_TFT_Control, pTFTHandle->Init.GPIO_Pin_TFT_nRST, GPIO_PIN_SET);
	Delay_ms(120);

	TFT_Write(pTFTHandle, 0x02, 0x0000);
	TFT_Write(pTFTHandle, 0x03, 0x0000);
	TFT_Write(pTFTHandle, 0x04, 0x0001);
	TFT_Write(pTFTHandle, 0x05, 0x003F);
	TFT_Write(pTFTHandle, 0x06, 0x0000);
	TFT_Write(pTFTHandle, 0x07, 0x0000);
	TFT_Write(pTFTHandle, 0x08, 0x0000);
	TFT_Write(pTFTHandle, 0x09, 0x00EF);

	TFT_Write(pTFTHandle, 0x01, 0x0006);
	TFT_Write(pTFTHandle, 0x16, 0x0068);
	TFT_Write(pTFTHandle, 0x18, 0x0000);
	TFT_Write(pTFTHandle, 0x70, 0x0065);
	TFT_Write(pTFTHandle, 0x23, 0x0095);
	TFT_Write(pTFTHandle, 0x24, 0x0095);
	TFT_Write(pTFTHandle, 0x25, 0x00FF);
	TFT_Write(pTFTHandle, 0x27, 0x0002);
	TFT_Write(pTFTHandle, 0x28, 0x0002);
	TFT_Write(pTFTHandle, 0x29, 0x0002);
	TFT_Write(pTFTHandle, 0x2A, 0x0002);
	TFT_Write(pTFTHandle, 0x2C, 0x0002);
	TFT_Write(pTFTHandle, 0x2D, 0x0002);
	TFT_Write(pTFTHandle, 0x3A, 0x0001);
	TFT_Write(pTFTHandle, 0x3B, 0x0001);
	TFT_Write(pTFTHandle, 0x3C, 0x00F0);
	TFT_Write(pTFTHandle, 0x3D, 0x0000);
	Delay_ms(20);
	TFT_Write(pTFTHandle, 0x35, 0x0038);
	TFT_Write(pTFTHandle, 0x36, 0x0078);
	TFT_Write(pTFTHandle, 0x3E, 0x0038);
	TFT_Write(pTFTHandle, 0x40, 0x000F);
	TFT_Write(pTFTHandle, 0x41, 0x00F0);

	TFT_Write(pTFTHandle, 0x19, 0x0049);
	TFT_Write(pTFTHandle, 0x93, 0x000F);
	Delay_ms(10);
	TFT_Write(pTFTHandle, 0x20, 0x0040);
	TFT_Write(pTFTHandle, 0x1D, 0x0007);
	Delay_ms(10);
	TFT_Write(pTFTHandle, 0x1E, 0x0000);
	TFT_Write(pTFTHandle, 0x1F, 0x0004);
	TFT_Write(pTFTHandle, 0x44, 0x0040);
	TFT_Write(pTFTHandle, 0x45, 0x0012);
	Delay_ms(10);
	TFT_Write(pTFTHandle, 0x1C, 0x0004);
	Delay_ms(20);
	TFT_Write(pTFTHandle, 0x43, 0x0080);
	Delay_ms(5);
	TFT_Write(pTFTHandle, 0x1B, 0x0018);
	Delay_ms(40);
	TFT_Write(pTFTHandle, 0x1B, 0x0010);
	Delay_ms(40);

	TFT_Write(pTFTHandle, 0x46, 0x00A4);
	TFT_Write(pTFTHandle, 0x47, 0x0053);
	TFT_Write(pTFTHandle, 0x48, 0x0010);
	TFT_Write(pTFTHandle, 0x49, 0x005F);
	TFT_Write(pTFTHandle, 0x4A, 0x0004);
	TFT_Write(pTFTHandle, 0x4B, 0x003F);
	TFT_Write(pTFTHandle, 0x4C, 0x0002);
	TFT_Write(pTFTHandle, 0x4D, 0x00F6);
	TFT_Write(pTFTHandle, 0x4E, 0x0012);
	TFT_Write(pTFTHandle, 0x4F, 0x004C);
	TFT_Write(pTFTHandle, 0x50, 0x0046);
	TFT_Write(pTFTHandle, 0x51, 0x0044);

	TFT_Write(pTFTHandle, 0x90, 0x007F);
	TFT_Write(pTFTHandle, 0x26, 0x0004);
	Delay_ms(40);
	TFT_Write(pTFTHandle, 0x26, 0x0024);
	TFT_Write(pTFTHandle, 0x26, 0x002C);
	Delay_ms(40);
	TFT_Write(pTFTHandle, 0x26, 0x003C);

	TFT_Write(pTFTHandle, 0x57, 0x0002);
	TFT_Write(pTFTHandle, 0x55, 0x0000);
	TFT_Write(pTFTHandle, 0xFE, 0x005A);
	TFT_Write(pTFTHandle, 0x57, 0x0000);

	TFT_Clear_Screen(pTFTHandle);
}


__weak void TFT_MspInit(TFT_HandleTypeDef *pTFTHandle)
{
	/* Prevent unused argument(s) compilation warning */
		UNUSED(pTFTHandle);

	/* NOTE : This function should not be modified, when the callback is needed,
	 * 		  the TFT_MspInit could be implemented in the user file
	 * 		  (This is a weak implementation. The user application may override this function)
	 */
}


void TFT_Command(TFT_HandleTypeDef *pTFTHandle, uint16_t indexRegister)
{
	GPIO_WritePin(pTFTHandle->Init.GPIOx_TFT_Control, pTFTHandle->Init.GPIO_Pin_TFT_nCS | pTFTHandle->Init.GPIO_Pin_TFT_RS, GPIO_PIN_RESET);
	GPIO_WriteData(pTFTHandle->Init.GPIOx_TFT_Data, indexRegister);
	GPIO_WritePin(pTFTHandle->Init.GPIOx_TFT_Control, pTFTHandle->Init.GPIO_Pin_TFT_nWR, GPIO_PIN_RESET);
	asm("NOP");
	asm("NOP");
	asm("NOP");
	asm("NOP");
	asm("NOP");
	asm("NOP");
	asm("NOP");
	asm("NOP");
	GPIO_WritePin(pTFTHandle->Init.GPIOx_TFT_Control, pTFTHandle->Init.GPIO_Pin_TFT_nWR, GPIO_PIN_SET);
	asm("NOP");
	GPIO_WritePin(pTFTHandle->Init.GPIOx_TFT_Control, pTFTHandle->Init.GPIO_Pin_TFT_nCS, GPIO_PIN_SET);
}


void TFT_Data(TFT_HandleTypeDef *pTFTHandle, uint16_t data)
{
	GPIO_ModifyPin(pTFTHandle->Init.GPIOx_TFT_Control, pTFTHandle->Init.GPIO_Pin_TFT_RS, pTFTHandle->Init.GPIO_Pin_TFT_nCS);
	GPIO_WriteData(pTFTHandle->Init.GPIOx_TFT_Data, data);
	GPIO_WritePin(pTFTHandle->Init.GPIOx_TFT_Control, pTFTHandle->Init.GPIO_Pin_TFT_nWR, GPIO_PIN_RESET);
	asm("NOP");
	asm("NOP");
	asm("NOP");
	asm("NOP");
	asm("NOP");
	asm("NOP");
	asm("NOP");
	asm("NOP");
	GPIO_WritePin(pTFTHandle->Init.GPIOx_TFT_Control, pTFTHandle->Init.GPIO_Pin_TFT_nWR, GPIO_PIN_SET);
	asm("NOP");
	GPIO_WritePin(pTFTHandle->Init.GPIOx_TFT_Control, pTFTHandle->Init.GPIO_Pin_TFT_nCS, GPIO_PIN_SET);
}


void TFT_Write(TFT_HandleTypeDef *pTFTHandle, uint16_t reg, uint16_t val)
{
	TFT_Command(pTFTHandle, reg);
	TFT_Data(pTFTHandle, val);
}


void TFT_Clear_Screen(TFT_HandleTypeDef *pTFTHandle)
{
	TFT_Color_Screen(pTFTHandle, Black);
}


void TFT_Color_Screen(TFT_HandleTypeDef *pTFTHandle, uint16_t color)
{
	uint16_t i, j;

	TFT_GRAM_Address(pTFTHandle, 0, 0);

	for(i = 0; i < 320; i++)
	{
		for(j = 0; j < 240; j++)
		{
			TFT_Data(pTFTHandle, color);
		}
	}
}


void TFT_GRAM_Address(TFT_HandleTypeDef *pTFTHandle, uint16_t xPos, uint16_t yPos)
{
	if(pTFTHandle->ScreenMode == 'L')
	{
		if((xPos > 319) || (yPos > 239))	return;

		TFT_Write(pTFTHandle, 0x02, xPos >> 8);
		TFT_Write(pTFTHandle, 0x03, xPos & 0x00FF);
		TFT_Write(pTFTHandle, 0x06, 0x0000);
		TFT_Write(pTFTHandle, 0x07, yPos);
	}
	else
	{
		if((xPos > 239) || (yPos > 319))	return;

		TFT_Write(pTFTHandle, 0x02, 0x0000);
		TFT_Write(pTFTHandle, 0x03, xPos);
		TFT_Write(pTFTHandle, 0x06, yPos >> 8);
		TFT_Write(pTFTHandle, 0x07, yPos & 0x00FF);
	}

	TFT_Command(pTFTHandle, 0x22);
}


void TFT_xy(TFT_HandleTypeDef *pTFTHandle, uint8_t xChar, uint8_t yChar)
{
	pTFTHandle->Xcharacter = xChar;
	pTFTHandle->Ycharacter = yChar;
}


void TFT_Color(TFT_HandleTypeDef *pTFTHandle, uint16_t colorfore, uint16_t colorback)
{
	pTFTHandle->foreground = colorfore;
	pTFTHandle->background = colorback;
}


void TFT_Pixel(TFT_HandleTypeDef *pTFTHandle, uint16_t xPos, uint16_t yPos, uint16_t color)
{
	if(pTFTHandle->ScreenMode == 'L')
	{
		if((xPos > 319) || (yPos > 239))	return;

		TFT_Write(pTFTHandle, 0x02, xPos >> 8);
		TFT_Write(pTFTHandle, 0x03, xPos & 0x00FF);
		TFT_Write(pTFTHandle, 0x06, 0x0000);
		TFT_Write(pTFTHandle, 0x07, yPos);
	}
	else
	{
		if((xPos > 239) || (yPos > 319))	return;

		TFT_Write(pTFTHandle, 0x02, 0x0000);
		TFT_Write(pTFTHandle, 0x03, xPos);
		TFT_Write(pTFTHandle, 0x06, yPos >> 8);
		TFT_Write(pTFTHandle, 0x07, yPos & 0x00FF);
	}

	if(color != Transparent)	TFT_Write(pTFTHandle, 0x22, color);
}


void TFT_Landscape_mode(TFT_HandleTypeDef *pTFTHandle)
{
	TFT_Write(pTFTHandle, 0x16, 0x0068);
	TFT_Write(pTFTHandle, 0x02, 0x0000);
	TFT_Write(pTFTHandle, 0x03, 0x0000);
	TFT_Write(pTFTHandle, 0x04, 0x0001);
	TFT_Write(pTFTHandle, 0x05, 0x003F);
	TFT_Write(pTFTHandle, 0x06, 0x0000);
	TFT_Write(pTFTHandle, 0x07, 0x0000);
	TFT_Write(pTFTHandle, 0x08, 0x0000);
	TFT_Write(pTFTHandle, 0x09, 0x00EF);

	pTFTHandle->XcharacterLimit = 40;
	pTFTHandle->YcharacterLimit = 30;
	pTFTHandle->XcharacterLimit_Large = 26;
	pTFTHandle->YcharacterLimit_Large = 30;
	pTFTHandle->ScreenMode = 'L';
}


void TFT_Portrait_mode(TFT_HandleTypeDef *pTFTHandle)
{
	TFT_Write(pTFTHandle, 0x16, 0x0008);
	TFT_Write(pTFTHandle, 0x02, 0x0000);
	TFT_Write(pTFTHandle, 0x03, 0x0000);
	TFT_Write(pTFTHandle, 0x04, 0x0000);
	TFT_Write(pTFTHandle, 0x05, 0x00EF);
	TFT_Write(pTFTHandle, 0x06, 0x0000);
	TFT_Write(pTFTHandle, 0x07, 0x0000);
	TFT_Write(pTFTHandle, 0x08, 0x0001);
	TFT_Write(pTFTHandle, 0x09, 0x003F);

	pTFTHandle->XcharacterLimit = 30;
	pTFTHandle->YcharacterLimit = 40;
	pTFTHandle->XcharacterLimit_Large = 20;
	pTFTHandle->YcharacterLimit_Large = 40;
	pTFTHandle->ScreenMode = 'P';
}


void TFT_Cursor(TFT_HandleTypeDef *pTFTHandle, uint16_t cursor_color)
{
	if(cursor_color == Transparent)
	{
		pTFTHandle->cursor_flag = 0;
	}
	else
	{
		pTFTHandle->cursor_flag = 1;
		pTFTHandle->cursor = cursor_color;
	}

}


void TFT_Underscore(TFT_HandleTypeDef *pTFTHandle, uint16_t underscore_color)
{
	if(underscore_color == Transparent)
	{
		pTFTHandle->underscore_flag = 0;
	}
	else
	{
		pTFTHandle->underscore_flag = 1;
		pTFTHandle->underscore = underscore_color;
	}
}


void TFT_Outline(TFT_HandleTypeDef *pTFTHandle, uint16_t outline_color)
{
	if(outline_color == Transparent)
	{
		pTFTHandle->outline_flag = 0;
	}
	else
	{
		pTFTHandle->outline_flag = 1;
		pTFTHandle->outline = outline_color;
	}
}


void TFT_String(TFT_HandleTypeDef *pTFTHandle, uint8_t xChar, uint8_t yChar, uint16_t colorfore, uint16_t colorback, uint8_t *str)
{
	uint8_t ch1;

	pTFTHandle->Xcharacter = xChar;
	pTFTHandle->Ycharacter = yChar;

	pTFTHandle->foreground = colorfore;
	pTFTHandle->background = colorback;

	while(*str)
	{
		ch1 = *str;
		str++;

		if(ch1 < 0x80)
		{
			TFT_English(pTFTHandle, ch1);
		}
	}
}


void TFT_String_Large(TFT_HandleTypeDef *pTFTHandle, uint8_t xChar, uint8_t yChar, uint16_t colorfore, uint16_t colorback, uint8_t *str)
{
	uint8_t ch1;

	pTFTHandle->Xcharacter = xChar;
	pTFTHandle->Ycharacter = yChar;

	pTFTHandle->foreground = colorfore;
	pTFTHandle->background = colorback;

	pTFTHandle->nextline_flag = 0;

	while(*str)
	{
		ch1 = *str;
		str++;

		if(ch1 < 0x80)
		{
			TFT_English_Large(pTFTHandle, ch1);
		}
	}
}


void TFT_English(TFT_HandleTypeDef *pTFTHandle, uint8_t code)
{
	uint8_t data, x, y;
	uint16_t pixel[8][16];
	uint16_t xPos, yPos, dot0, dot1, dot2, dot3, dot4;

	for(x = 0; x < 8; x++)
	{
		data = E_font[code][x];

		for(y = 0; y < 8; y++)
		{
			if(data & 0x01)		pixel[x][y] = pTFTHandle->foreground;
			else				pixel[x][y] = pTFTHandle->background;

			data = data >> 1;
		}
	}

	for(x = 0; x < 8; x++)
	{
		data = E_font[code][x+8];

		for(y = 0; y < 8; y++)
		{
			if(data & 0x01)		pixel[x][y+8] = pTFTHandle->foreground;
			else				pixel[x][y+8] = pTFTHandle->background;

			data = data >> 1;
		}
	}

	if(pTFTHandle->outline_flag == 1)
	{
		for(x = 0; x < 8; x++)
		{
			dot0 = E_font[code][x] + E_font[code][x+8]*256;
			dot1 = dot0 >> 1;
			dot2 = dot0;
			dot3 = E_font[code][x+1] + E_font[code][x+9]*256;
			dot4 = E_font[code][x-1] + E_font[code][x+7]*256;

			for(y = 0; y < 15; y++)
			{
				if(!(dot0 & 0x0001))
				{
					if(dot1 & 0x0001)		pixel[x][y] = pTFTHandle->outline;
					if(dot2 & 0x0001)		pixel[x][y] = pTFTHandle->outline;
					if((dot3 & 0x0001) && (x < 7))		pixel[x][y] = pTFTHandle->outline;
					if((dot4 & 0x0001) && (x > 0))		pixel[x][y] = pTFTHandle->outline;
				}

				dot1 >>= 1;
				dot2 = dot0;
				dot0 >>= 1;
				dot3 >>= 1;
				dot4 >>= 1;
			}
		}
	}

	if(pTFTHandle->Xcharacter >= pTFTHandle->XcharacterLimit)
	{
		pTFTHandle->nextline_flag = 1;
		pTFTHandle->Xcharacter = 0;
		pTFTHandle->Ycharacter += 2;

		if(pTFTHandle->Ycharacter >= (pTFTHandle->YcharacterLimit - 1))		pTFTHandle->Ycharacter = 0;
	}

	if(pTFTHandle->underscore_flag == 1)
	{
		for(x = 0; x < 8; x++)
		{
			pixel[x][15] = pTFTHandle->underscore;
		}
	}

	if((pTFTHandle->cursor_flag == 1) && (pTFTHandle->Xcharacter == pTFTHandle->Xcursor) && (pTFTHandle->Ycharacter == pTFTHandle->Ycursor))
	{
		for(x = 0; x < 8; x++)
		{
			pixel[x][14] = pTFTHandle->cursor;
			pixel[x][15] = pTFTHandle->cursor;
		}
	}


	if(pTFTHandle->background != Transparent)
	{
		xPos = pTFTHandle->Xcharacter * 8;

		for(y = 0; y < 16; y++)
		{
			yPos = pTFTHandle->Ycharacter * 8 + y;

			if(pTFTHandle->ScreenMode == 'L')
			{
				TFT_Write(pTFTHandle, 0x02, xPos >> 8);
				TFT_Write(pTFTHandle, 0x03, xPos & 0x00FF);
				TFT_Write(pTFTHandle, 0x06, 0x0000);
				TFT_Write(pTFTHandle, 0x07, yPos);
			}
			else
			{
				TFT_Write(pTFTHandle, 0x02, 0x0000);
				TFT_Write(pTFTHandle, 0x03, xPos);
				TFT_Write(pTFTHandle, 0x06, yPos >> 8);
				TFT_Write(pTFTHandle, 0x07, yPos & 0x00FF);
			}

			TFT_Command(pTFTHandle, 0x22);
			TFT_Data(pTFTHandle, pixel[0][y]);
			TFT_Data(pTFTHandle, pixel[1][y]);
			TFT_Data(pTFTHandle, pixel[2][y]);
			TFT_Data(pTFTHandle, pixel[3][y]);
			TFT_Data(pTFTHandle, pixel[4][y]);
			TFT_Data(pTFTHandle, pixel[5][y]);
			TFT_Data(pTFTHandle, pixel[6][y]);
			TFT_Data(pTFTHandle, pixel[7][y]);
		}
	}
	else
	{
		for(y = 0; y < 16; y++)
		{
			for(x = 0; x < 8; x++)
			{
				TFT_Pixel(pTFTHandle, pTFTHandle->Xcharacter * 8 + x, pTFTHandle->Ycharacter * 8 + y, pixel[x][y]);
			}
		}
	}

	pTFTHandle->Xcharacter += 1;
}


void TFT_English_Large(TFT_HandleTypeDef *pTFTHandle, uint8_t code)
{
	uint8_t data, x, y;
	uint16_t pixel[12][24];
	uint16_t xPos, yPos, dot0, dot1, dot2, dot3, dot4;

	for(x = 0; x < 12; x++)
	{
		data = E_font_large[code][x];

		for(y = 0; y < 8; y++)
		{
			if(data & 0x01)		pixel[x][y] = pTFTHandle->foreground;
			else				pixel[x][y] = pTFTHandle->background;

			data = data >> 1;
		}
	}

	for(x = 0; x < 12; x++)
	{
		data = E_font_large[code][x+12];

		for(y = 0; y < 8; y++)
		{
			if(data & 0x01)		pixel[x][y+8] = pTFTHandle->foreground;
			else				pixel[x][y+8] = pTFTHandle->background;

			data = data >> 1;
		}
	}


	for(x = 0; x < 12; x++)
	{
		data = E_font_large[code][x+24];

		for(y = 0; y < 8; y++)
		{
			if(data & 0x01)		pixel[x][y+16] = pTFTHandle->foreground;
			else				pixel[x][y+16] = pTFTHandle->background;

			data = data >> 1;
		}
	}


	if(pTFTHandle->outline_flag == 1)
	{
		for(x = 0; x < 12; x++)
		{
			dot0 = E_font_large[code][x] + E_font_large[code][x+12]*256;
			dot1 = dot0 >> 1;
			dot2 = dot0;
			dot3 = E_font_large[code][x+1] + E_font_large[code][x+13]*256;
			dot4 = E_font_large[code][x-1] + E_font_large[code][x+11]*256;

			for(y = 0; y < 15; y++)
			{
				if(!(dot0 & 0x0001))
				{
					if(dot1 & 0x0001)		pixel[x][y] = pTFTHandle->outline;
					if(dot2 & 0x0001)		pixel[x][y] = pTFTHandle->outline;
					if((dot3 & 0x0001) && (x < 11))		pixel[x][y] = pTFTHandle->outline;
					if((dot4 & 0x0001) && (x > 0))		pixel[x][y] = pTFTHandle->outline;
				}

				dot1 >>= 1;
				dot2 = dot0;
				dot0 >>= 1;
				dot3 >>= 1;
				dot4 >>= 1;
			}
		}

		for(x = 0; x < 12; x++)
		{
			dot0 = E_font_large[code][x+12] + E_font_large[code][x+24]*256;
			dot1 = dot0 >> 1;
			dot2 = dot0;
			dot3 = E_font_large[code][x+13] + E_font_large[code][x+25]*256;
			dot4 = E_font_large[code][x+11] + E_font_large[code][x+23]*256;

			for(y = 0; y < 16; y++)
			{
				if(!(dot0 & 0x0001))
				{
					if(dot1 & 0x0001)		pixel[x][y+8] = pTFTHandle->outline;
					if(dot2 & 0x0001)		pixel[x][y+8] = pTFTHandle->outline;
					if((dot3 & 0x0001) && (x < 11))		pixel[x][y+8] = pTFTHandle->outline;
					if((dot4 & 0x0001) && (x > 0))		pixel[x][y+8] = pTFTHandle->outline;
				}

				dot1 >>= 1;
				dot2 = dot0;
				dot0 >>= 1;
				dot3 >>= 1;
				dot4 >>= 1;
			}
		}
	}

	if(pTFTHandle->Xcharacter >= pTFTHandle->XcharacterLimit_Large)
	{
		pTFTHandle->nextline_flag = 1;
		pTFTHandle->Xcharacter = 0;
		pTFTHandle->Ycharacter += 3;

		if(pTFTHandle->Ycharacter >= (pTFTHandle->YcharacterLimit_Large - 2))		pTFTHandle->Ycharacter = 0;
	}

	if(pTFTHandle->underscore_flag == 1)
	{
		for(x = 0; x < 12; x++)
		{
			pixel[x][23] = pTFTHandle->underscore;
		}
	}

	if((pTFTHandle->cursor_flag == 1) && (pTFTHandle->Xcharacter == pTFTHandle->Xcursor) && (pTFTHandle->Ycharacter == pTFTHandle->Ycursor))
	{
		for(x = 0; x < 12; x++)
		{
			pixel[x][22] = pTFTHandle->cursor;
			pixel[x][23] = pTFTHandle->cursor;
		}
	}

	if((pTFTHandle->nextline_flag == 1) && (pTFTHandle->Xcharacter == 0) && (code == ' '))
	{
		return;
	}
	else if(pTFTHandle->background != Transparent)
	{
		xPos = pTFTHandle->Xcharacter * 12;

		for(y = 0; y < 24; y++)
		{
			yPos = pTFTHandle->Ycharacter * 8 + y;

			if(pTFTHandle->ScreenMode == 'L')
			{
				TFT_Write(pTFTHandle, 0x02, xPos >> 8);
				TFT_Write(pTFTHandle, 0x03, xPos & 0x00FF);
				TFT_Write(pTFTHandle, 0x06, 0x0000);
				TFT_Write(pTFTHandle, 0x07, yPos);
			}
			else
			{
				TFT_Write(pTFTHandle, 0x02, 0x0000);
				TFT_Write(pTFTHandle, 0x03, xPos);
				TFT_Write(pTFTHandle, 0x06, yPos >> 8);
				TFT_Write(pTFTHandle, 0x07, yPos & 0x00FF);
			}

			TFT_Command(pTFTHandle, 0x22);
			TFT_Data(pTFTHandle, pixel[0][y]);
			TFT_Data(pTFTHandle, pixel[1][y]);
			TFT_Data(pTFTHandle, pixel[2][y]);
			TFT_Data(pTFTHandle, pixel[3][y]);
			TFT_Data(pTFTHandle, pixel[4][y]);
			TFT_Data(pTFTHandle, pixel[5][y]);
			TFT_Data(pTFTHandle, pixel[6][y]);
			TFT_Data(pTFTHandle, pixel[7][y]);
			TFT_Data(pTFTHandle, pixel[8][y]);
			TFT_Data(pTFTHandle, pixel[9][y]);
			TFT_Data(pTFTHandle, pixel[10][y]);
			TFT_Data(pTFTHandle, pixel[11][y]);
		}
	}
	else
	{
		for(y = 0; y < 24; y++)
		{
			for(x = 0; x < 12; x++)
			{
				TFT_Pixel(pTFTHandle, pTFTHandle->Xcharacter * 12 + x, pTFTHandle->Ycharacter * 8 + y, pixel[x][y]);
			}
		}
	}

	pTFTHandle->Xcharacter += 1;
}


void TFT_English_pixel(TFT_HandleTypeDef *pTFTHandle, uint16_t Xpixel, uint16_t Ypixel, uint8_t code)
{
	uint8_t data, x, y;
	uint16_t pixel[8][16];

	for(x = 0; x < 8; x++)
	{
		data = E_font[code][x];

		for(y = 0; y < 8; y++)
		{
			if(data & 0x01)		pixel[x][y] = pTFTHandle->foreground;
			else				pixel[x][y] = pTFTHandle->background;

			data = data >> 1;
		}
	}

	for(x = 0; x < 8; x++)
	{
		data = E_font[code][x+8];

		for(y = 0; y < 8; y++)
		{
			if(data & 0x01)		pixel[x][y+8] = pTFTHandle->foreground;
			else				pixel[x][y+8] = pTFTHandle->background;

			data = data >> 1;
		}
	}

	for(y = 0; y < 16; y++)
	{
		for(x = 0; x < 8; x++)
		{
			TFT_Pixel(pTFTHandle, Xpixel + x, Ypixel + y, pixel[x][y]);
		}
	}
}


void TFT_Binary(TFT_HandleTypeDef *pTFTHandle, uint32_t number, uint8_t digit)
{
	uint8_t i;

	if((digit == 0) || (digit > 32))	return;

	for(i = digit; i > 0; i--)
	{
		TFT_English(pTFTHandle, ((number >> (i-1)) & 0x01) + '0');
	}
}


void TFT_Unsigned_decimal(TFT_HandleTypeDef *pTFTHandle, uint32_t number, uint8_t zerofill, uint8_t digit)
{
	uint8_t zero_flag, character;
	uint32_t div;

	if((digit == 0) || (digit > 9))		return ;

	div = 1;
	while(--digit)		div *= 10;

	zero_flag = zerofill;

	while(div > 0)
	{
		character = number / div;

		if((character == 0) && (zero_flag == 0) && (div != 1))
		{
			TFT_English(pTFTHandle, character + ' ');
		}
		else
		{
			zero_flag = 1;
			TFT_English(pTFTHandle, character + '0');
		}

		number %= div;
		div /= 10;
	}
}


void TFT_Signed_decimal(TFT_HandleTypeDef *pTFTHandle, int32_t number, uint8_t zerofill, uint8_t digit)
{
	uint8_t zero_flag, character;
	uint32_t div;

	if((digit == 0) || (digit > 9))		return;

	if(number >= 0)
	{
		TFT_English(pTFTHandle, '+');
	}
	else
	{
		TFT_English(pTFTHandle, '-');
		number = (-1) * number;
	}

	div = 1;

	while(--digit)		div *= 10;

	zero_flag = zerofill;

	while(div > 0)
	{
		character = number / div;

		if((character == 0) && (zero_flag == 0) && (div != 1))
		{
			TFT_English(pTFTHandle, character + ' ');
		}
		else
		{
			zero_flag = 1;
			TFT_English(pTFTHandle, character + '0');
		}

		number %= div;
		div /= 10;
	}
}


void TFT_Hexadecimal(TFT_HandleTypeDef *pTFTHandle, uint32_t number, uint8_t digit)
{
	uint8_t i, character;

	if((digit == 0) || (digit > 8))		return;

	for(i = digit; i > 0; i--)
	{
		character = (number >> 4 * (i-1)) & 0x0F;

		if(character < 10)		TFT_English(pTFTHandle, character + '0');
		else					TFT_English(pTFTHandle, character - 10 + 'A');
	}
}


void TFT_Unsigned_float(TFT_HandleTypeDef *pTFTHandle, float number, uint8_t integral, uint8_t fractional)
{
	uint8_t zero_flag, digit, character;
	uint32_t div, integer;

	digit = integral + fractional;

	if((integral == 0) || (fractional == 0) || (digit > 9))		return;

	div = 1;

	while(--digit)		div *= 10;

	while(fractional--)	number *= 10.;

	integer = (uint32_t)(number + 0.5);

	zero_flag = 0;
	digit = 1;

	while(div > 0)
	{
		character = integer / div;

		if((character == 0) && (zero_flag == 0) && (digit != integral))
		{
			TFT_English(pTFTHandle, character + ' ');
		}
		else
		{
			zero_flag = 1;
			TFT_English(pTFTHandle, character + '0');
		}

		integer %= div;
		div /= 10;

		if(digit == integral)		TFT_English(pTFTHandle, '.');

		digit++;
	}
}


void TFT_Signed_float(TFT_HandleTypeDef *pTFTHandle, float number, uint8_t integral, uint8_t fractional)
{
	uint8_t zero_flag, digit, character;
	uint32_t div, integer;

	digit = integral + fractional;

	if((integral == 0) || (fractional == 0) || (digit > 9))		return;

	if(number >= 0)
	{
		TFT_English(pTFTHandle, '+');
	}
	else
	{
		TFT_English(pTFTHandle, '-');
		number = (-1)*number;
	}

	div = 1;

	while(--digit)		div *= 10;

	while(fractional--)	number *= 10.;

	integer = (uint32_t)(number + 0.5);

	zero_flag = 0;

	digit = 1;

	while(div > 0)
	{
		character = integer / div;

		if((character == 0) && (zero_flag == 0) && (digit != integral))
		{
			TFT_English(pTFTHandle, character + ' ');
		}
		else
		{
			zero_flag = 1;
			TFT_English(pTFTHandle, character + '0');
		}

		integer %= div;
		div /= 10;

		if(digit == integral)		TFT_English(pTFTHandle, '.');

		digit++;
	}
}


void TFT_Line(TFT_HandleTypeDef *pTFTHandle, int16_t x1, int16_t y1, int16_t x2, int16_t y2, uint16_t color)
{
	int16_t x, y;

	if((x1 == x2) && (y1 == y2))
	{
		TFT_Pixel(pTFTHandle, x1, y1, color);
	}
	else
	{
		if(x1 < x2)		x = x2 - x1;
		else			x = x1 - x2;

		if(y1 < y2)		y = y2 - y1;
		else			y = y1 - y2;

		if((x >= y) && (x1 <= x2))
		{
			for(x = x1; x <= x2; x++)
			{
				y = y1 + (int32_t)(x - x1) * (int32_t)(y2 - y1) / (x2 - x1);
				TFT_Pixel(pTFTHandle, x, y, color);
			}
		}
		else if((x >= y) && (x1 > x2))
		{
			for(x = x1; x >= x2; x--)
			{
				y = y1 + (int32_t)(x - x1) * (int32_t)(y2 - y1) / (x2 - x1);
				TFT_Pixel(pTFTHandle, x, y, color);
			}
		}
		else if((x < y) && (y1 <= y2))
		{
			for(y = y1; y <= y2; y++)
			{
				x = x1 + (int32_t)(y - y1) * (int32_t)(x2 - x1) / (y2 - y1);
				TFT_Pixel(pTFTHandle, x, y, color);
			}
		}
		else if((x < y) && (y1 > y2))
		{
			for(y = y1; y >= y2; y--)
			{
				x = x1 + (int32_t)(y - y1) * (int32_t)(x2 - x1) / (y2 - y1);
				TFT_Pixel(pTFTHandle, x, y, color);
			}
		}
	}
}


void TFT_Rectangle(TFT_HandleTypeDef *pTFTHandle, int16_t x1, int16_t y1, int16_t x2, int16_t y2, uint16_t color)
{
	TFT_Line(pTFTHandle, x1, y1, x1, y2, color);
	TFT_Line(pTFTHandle, x2, y1, x2, y2, color);
	TFT_Line(pTFTHandle, x1, y1, x2, y1, color);
	TFT_Line(pTFTHandle, x1, y2, x2, y2, color);
}


void TFT_Block(TFT_HandleTypeDef *pTFTHandle, int16_t x1, int16_t y1, int16_t x2, int16_t y2, uint16_t color, uint16_t fill)
{
	int16_t i;

	TFT_Line(pTFTHandle, x1, y1, x1, y2, color);
	TFT_Line(pTFTHandle, x2, y1, x2, y2, color);
	TFT_Line(pTFTHandle, x1, y1, x2, y1, color);
	TFT_Line(pTFTHandle, x1, y2, x2, y2, color);

	if((y1 < y2) && (x1 != x2))
	{
		for(i = y1 + 1; i <= y2 - 1; i ++)
		{
			TFT_Line(pTFTHandle, x1 + 1, i, x2 - 1, i, fill);
		}
	}
	else if((y1 > y2) && (x1 != x2))
	{
		for(i = y2 + 1; i <= y1 - 1; i++)
		{
			TFT_Line(pTFTHandle, x1 + 1, i, x2 - 1, i, fill);
		}
	}
}


void TFT_Circle(TFT_HandleTypeDef *pTFTHandle, int16_t x1, int16_t y1, int16_t r, uint16_t color)
{
	int16_t x, y;
	float s;

	for(y = y1 - r*3/4; y <= y1 + r*3/4; y++)
	{
		s = sqrt((int32_t)r * (int32_t)r - (int32_t)(y - y1)* (int32_t)(y - y1) + 0.5);
		x = x1 + (int32_t)s;
		TFT_Pixel(pTFTHandle, x, y, color);
		x = x1 - (int32_t)s;
		TFT_Pixel(pTFTHandle, x, y, color);
	}

	for(x = x1 - r*3/4; x <= x1 + r*3/4; x++)
	{
		s = sqrt((int32_t)r * (int32_t)r - (int32_t)(x - x1) * (int32_t)(x - x1) + 0.5);
		y = y1 + (int32_t)s;
		TFT_Pixel(pTFTHandle, x, y, color);
		y = y1 - (int32_t)s;
		TFT_Pixel(pTFTHandle, x, y, color);
	}
}


void TFT_Sine(TFT_HandleTypeDef *pTFTHandle, int16_t peak, uint8_t mode, uint16_t color)
{
	int16_t x, y;
	float pi = 3.141592654;

	if(mode == 0)
	{
		for(x = 0; x <= 319; x ++)
		{
			y = 120 - (int32_t)(sin((float)x * 1.6875 * pi / 180.) * peak + 0.5);
			TFT_Pixel(pTFTHandle, x, y, color);
		}
	}
	else
	{
		for(x = 0; x <= 319; x++)
		{
			y = 120 + (int32_t)(sin((float)x * 1.6875 * pi / 180.) * peak + 0.5);
			TFT_Pixel(pTFTHandle, x, y, color);
		}
	}
}
